granum-space/cansat-2016/documents/макет.jpg

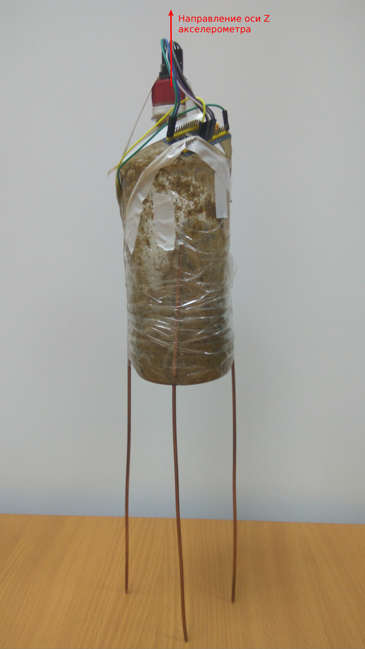
documents/макет.jpg
