granum-space/cansat-2016/documents/фото с полигона.jpg

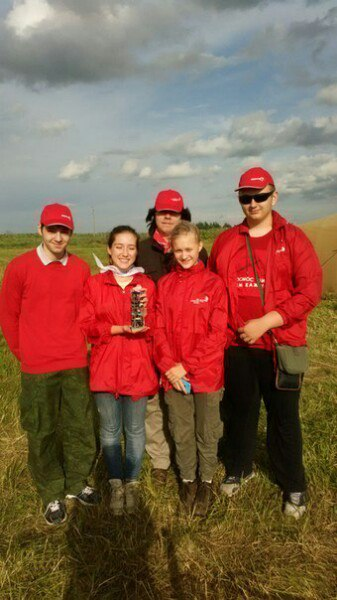
documents/фото с полигона.jpg
