granum-space/cansat-2016/README.md

# cansat-2016
проект команды granum конкурса cansat 2016
