granum-space/cansat-2016/schematics/README.md

# cansat-2016
Электронные схемы аппарата
