granum-space/cansat-2016/src-ground/README.md

# cansat-2016
Проект обработки телеметрии
