granum-space/cansat-2016/structure/README.md

# cansat-2016
Конструкция корпуса (модели/чертежи)
