granum-space/cansat-2016/documents/Granum Summer session 2017.pptx

## Granum

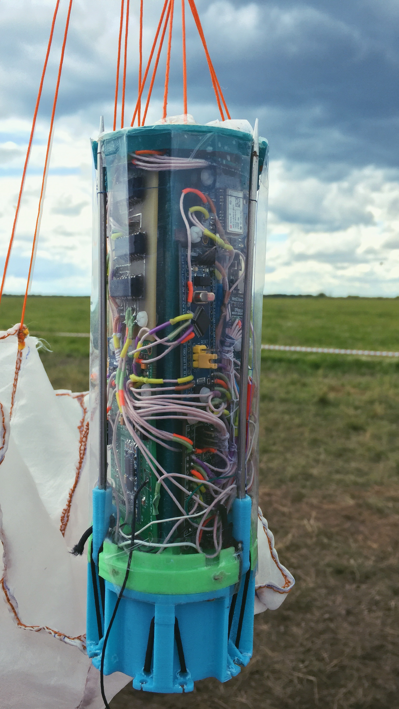
[picture p3: figure]

Проект 2501-2 «Е.Н.О.Т»

- В рамках воздушно-инженерной школы «CanSat в России»

Над проектом работали:
Елютин Кирилл,
Журавлёва Инга,
Хрисанова Анна,
руководитель:
Прокопьев василий

## ЗАДАЧИ аппарата

Задачи основной программы | Задачи дополнительной программы
Обеспечение плавного спуска и посадки | Измерение параметров почвы (электрическое сопротивление, твердость и температура)
Измерение давления, ускорения и температуры | Измерение относительной влажности воздуха
Передача собранных данных по радиоканалу | Измерение параметров освещенности
| Доставка семян
| Сохранение телеметрии на SD карту
| Определение координат аппарата по GPS

## Архитектура аппарата

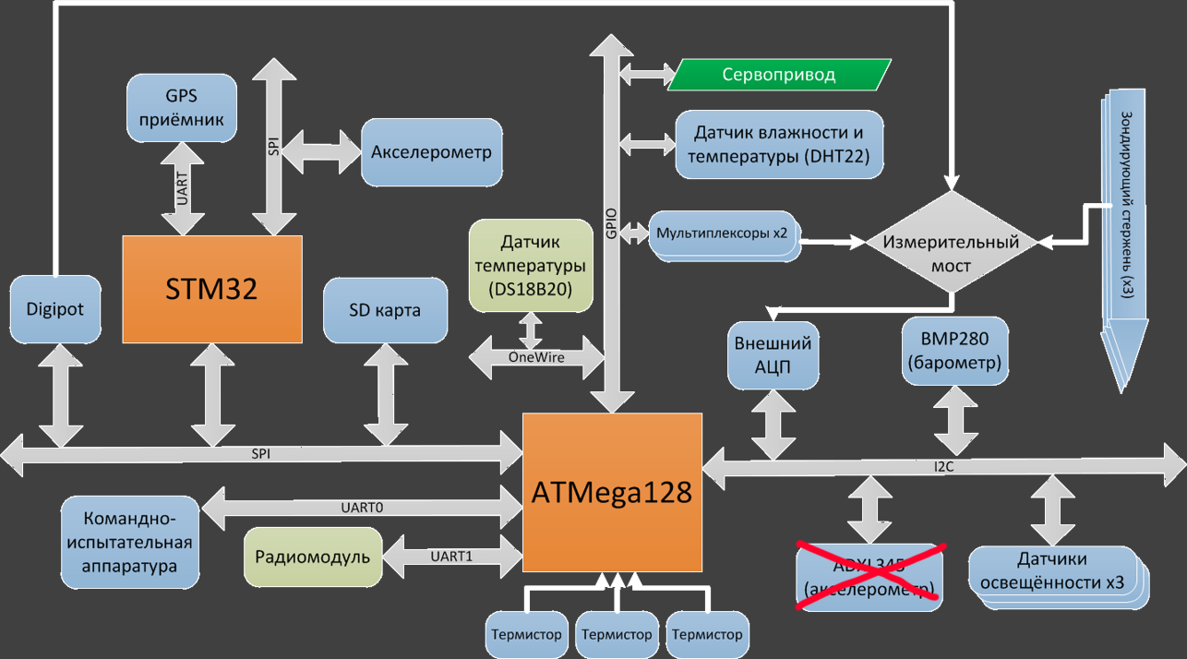
[picture p4: figure]

## Основная миссия

Измерение температуры

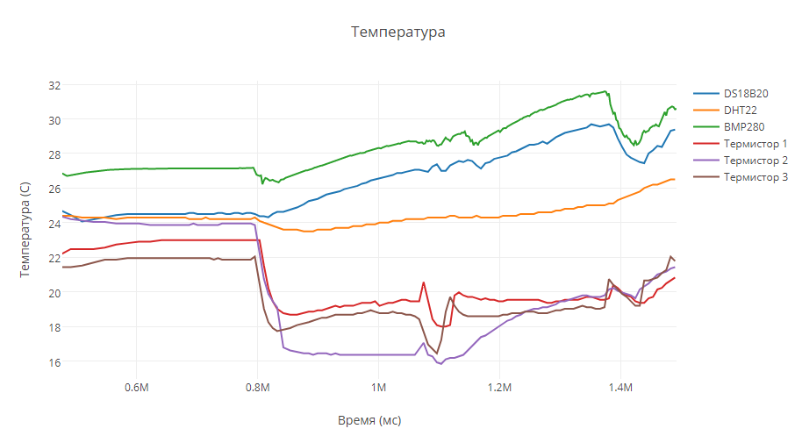
[picture p5: figure]
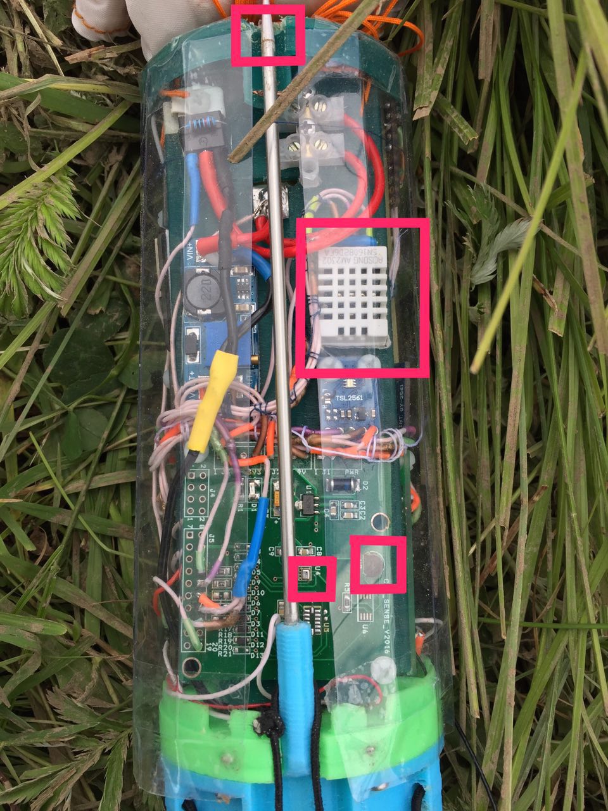
[picture p6: figure]

## Основная миссия

Измерение давления

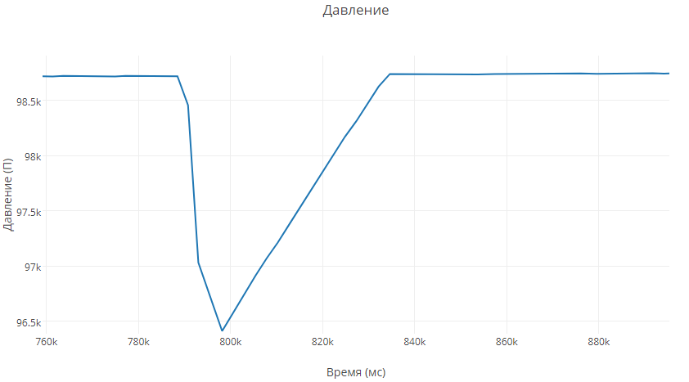
[picture p7: figure]
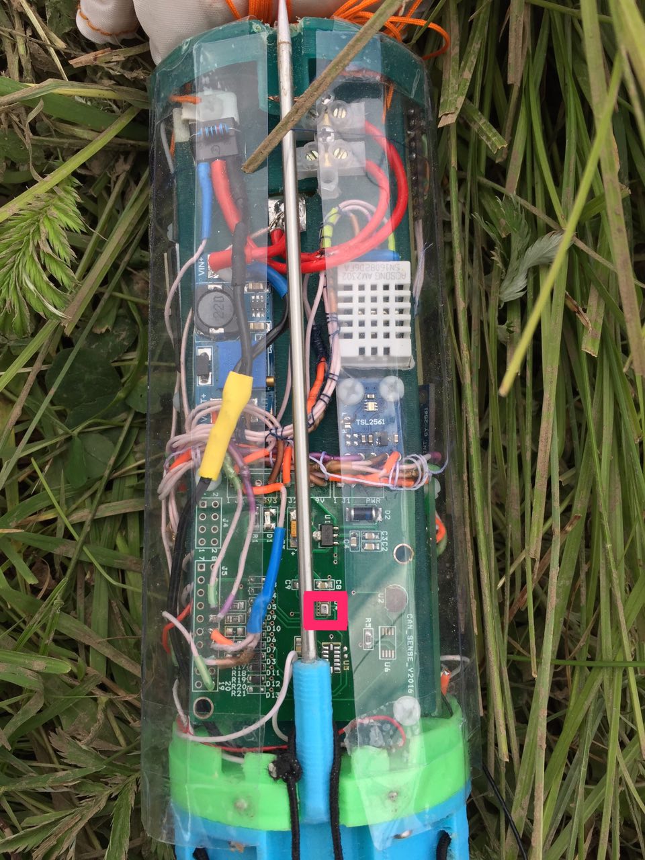
[picture p8: figure]
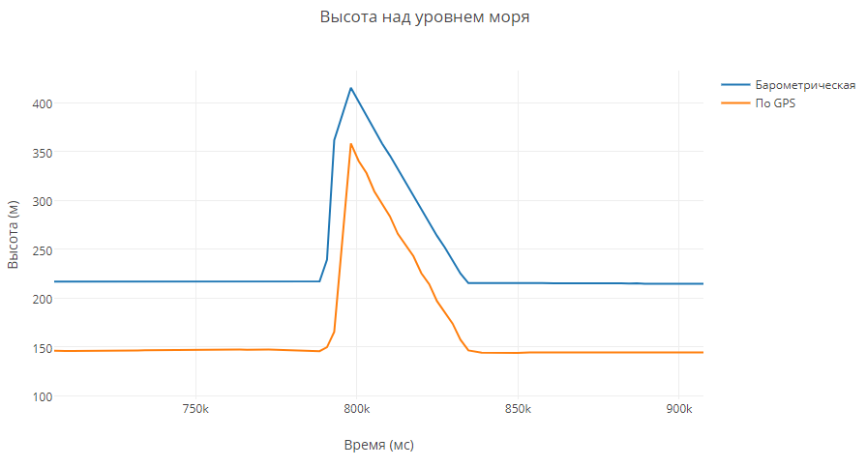
[picture p9: figure]

Скорость спуска ~ 5 м/с

Кинетическая энергия
полета: ~ 4.3 Дж

## дополнительная миссия

Измерение освещённости

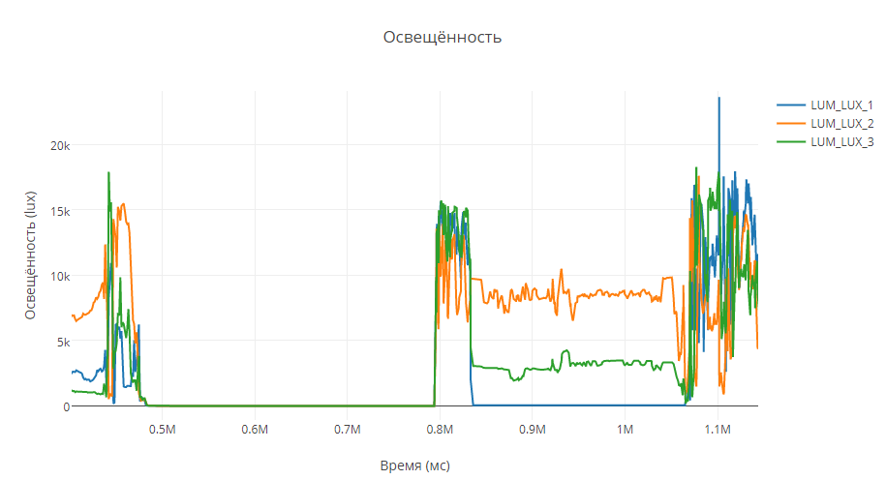
[picture p10: figure]
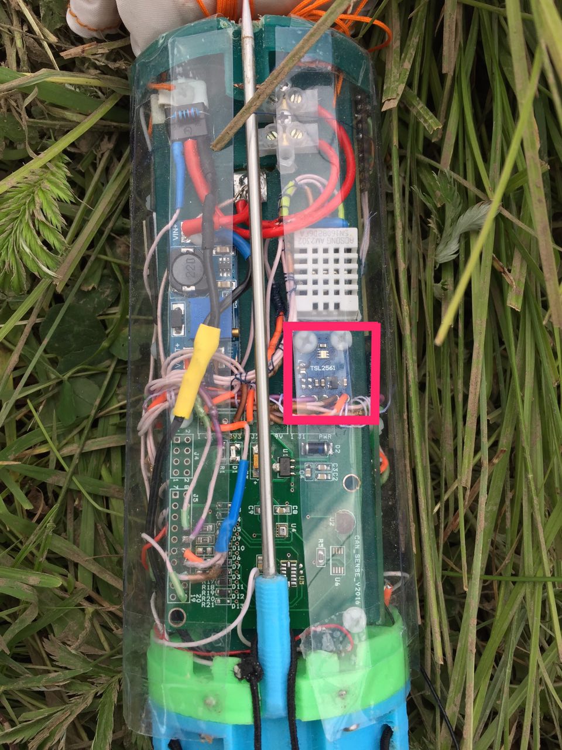
[picture p11: figure]
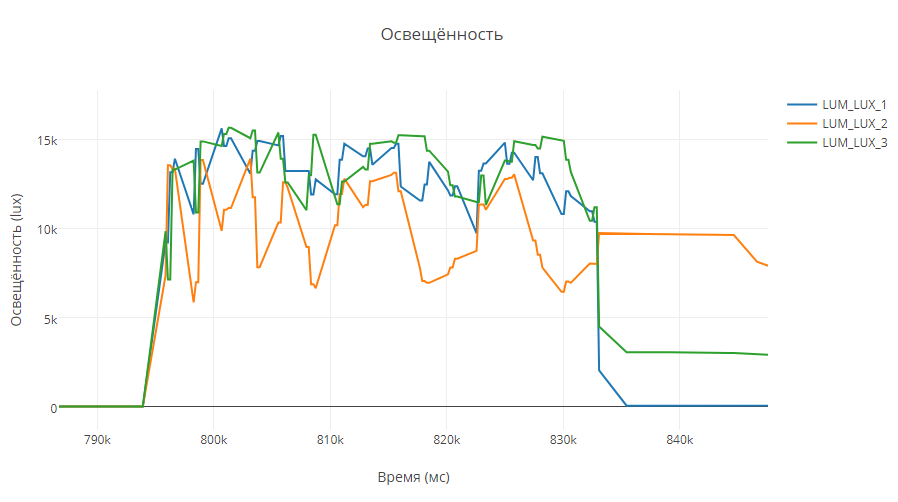
[picture p12: figure]

## дополнительная миссия

Измерение ускорений

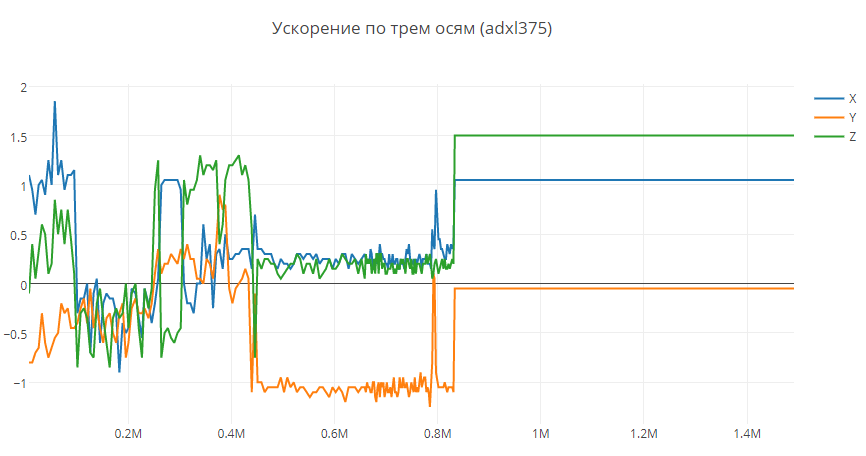
[picture p13: figure]
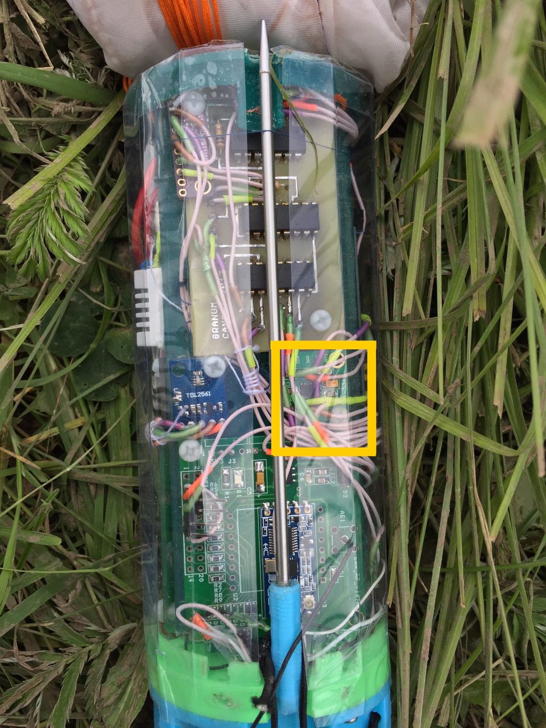
[picture p14: figure]
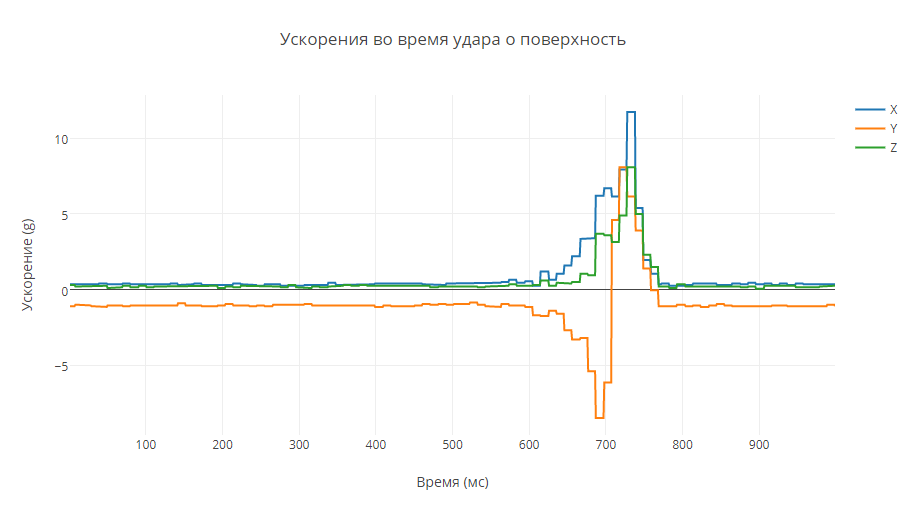
[picture p15: figure]

Время гашения удара: 100 мс

## дополнительная миссия

Измерение относительной влажности воздуха

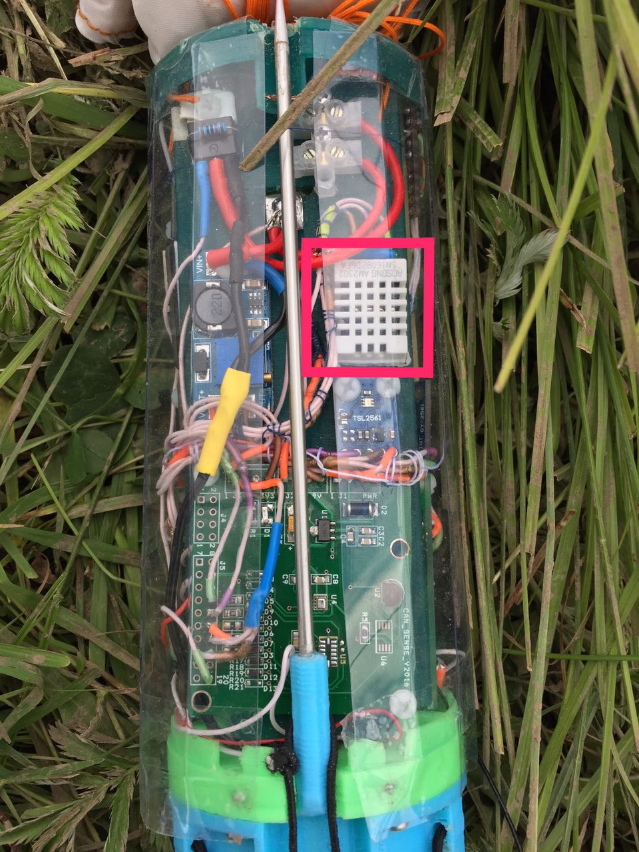
[picture p16: figure]
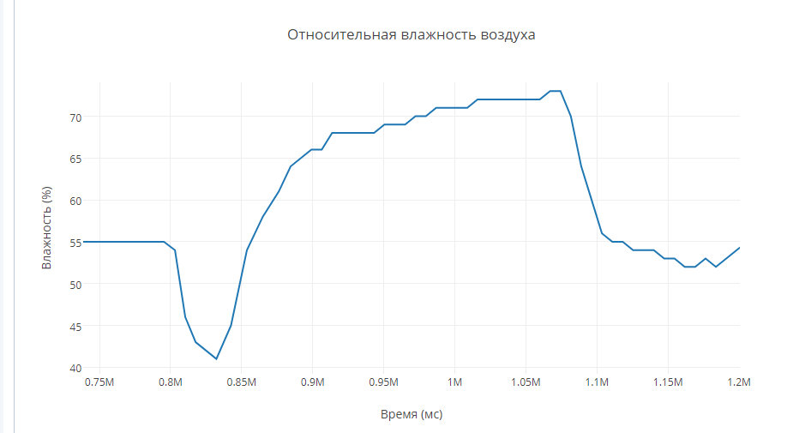
[picture p17: figure]

## дополнительная миссия

Измерение сопротивления почвы

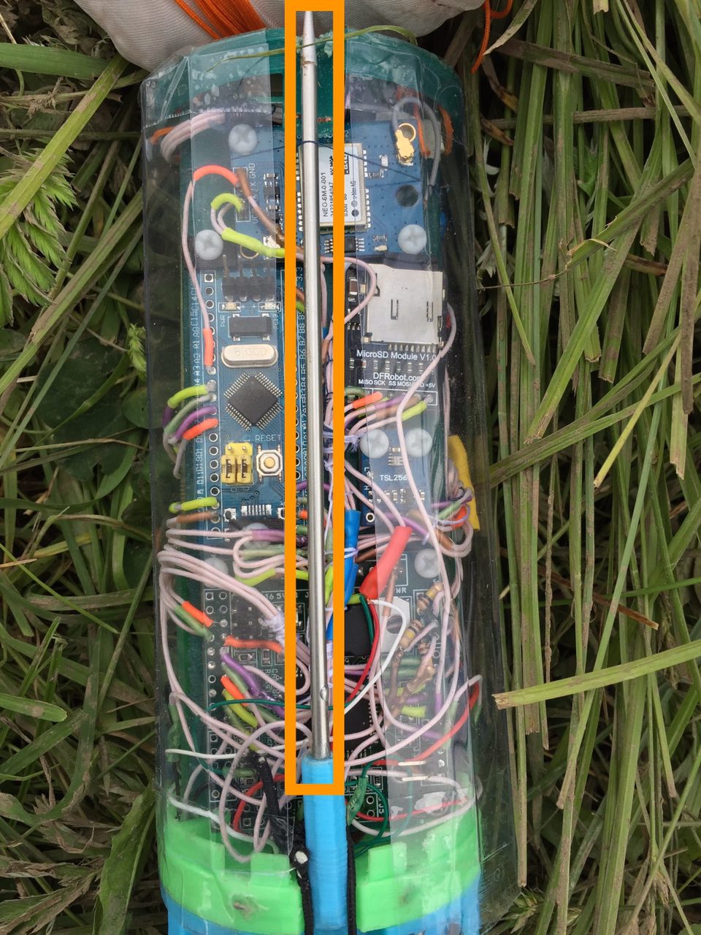
[picture p18: figure]
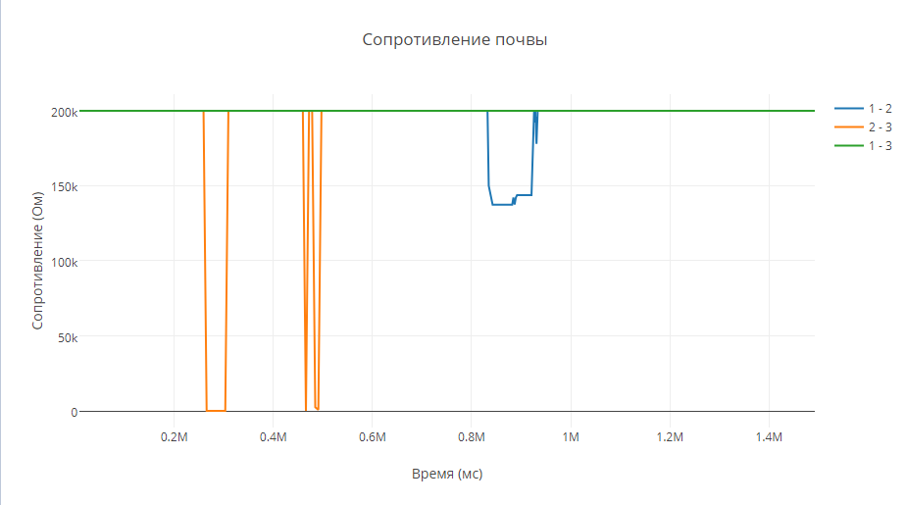
[picture p19: figure]

## дополнительная миссия

Разброс семян

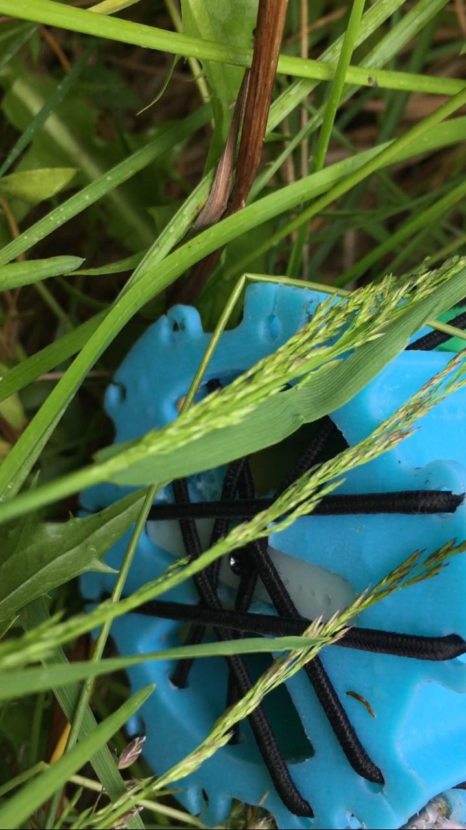
[picture p20: figure]
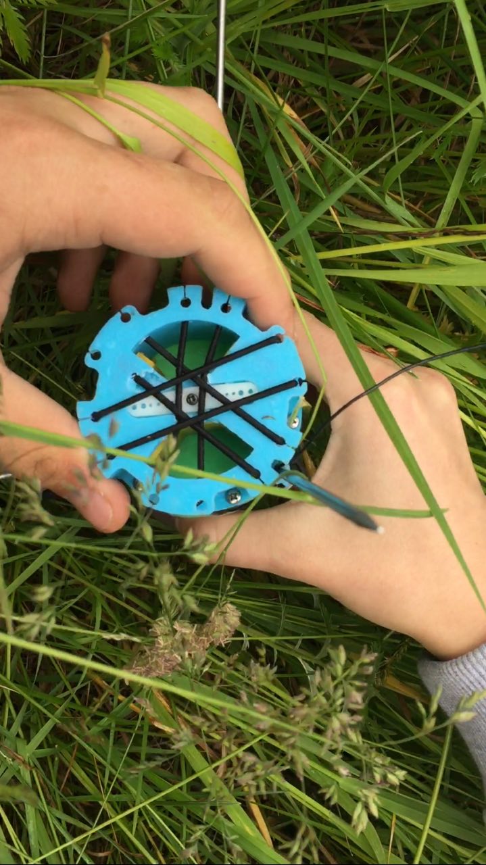
[picture p21: figure]

## результаты

- Сложенный парашют занимает больше двух сантиметров в высоту
- Все заявленные миссии выполнены в полном объеме без аппаратных и программных отказов в процессе полета
- Изучаемая планета по анализируемым параметрам пригодна для выращивания растений и похоже, что там что-то уже растет
