granum-space/cansat-2016/documents/Cansat-release.pdf

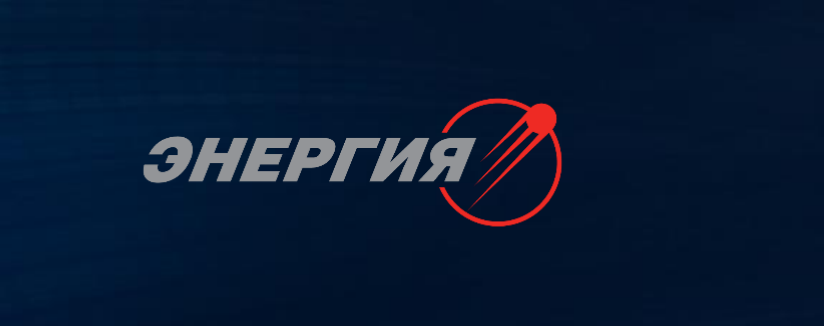
[picture p27: figure]

# Проект CanSat команды «Granum»

ЕКИМИАНИ Д., ЕЛЮТИН К., ЖУРАВЛЁВА И., НЕМИРОВА К., ХРИСАНОВА А.
КУРАТОР: ПРОКОПЬ ЕВ В.

# Цель проекта

### - Целью нашего проекта является создание аппарата для отработки некоторых компонентов, необходимых для изучения возможности

выращивания растений на удалённых планетах.

Задачи основной программы | Задачи дополнительной программы
Обеспечение плавного спуска и посадки | Измерение параметров атмосферы (влажность и содержаниеCО2 и О2)
Измерение давления и температуры | Измерение параметров почвы (электрическое сопротивление, твердость и температура)
| Измерение параметров освещенности на поверхности
| Доставка семян и бактерий

# Конструкция аппарата

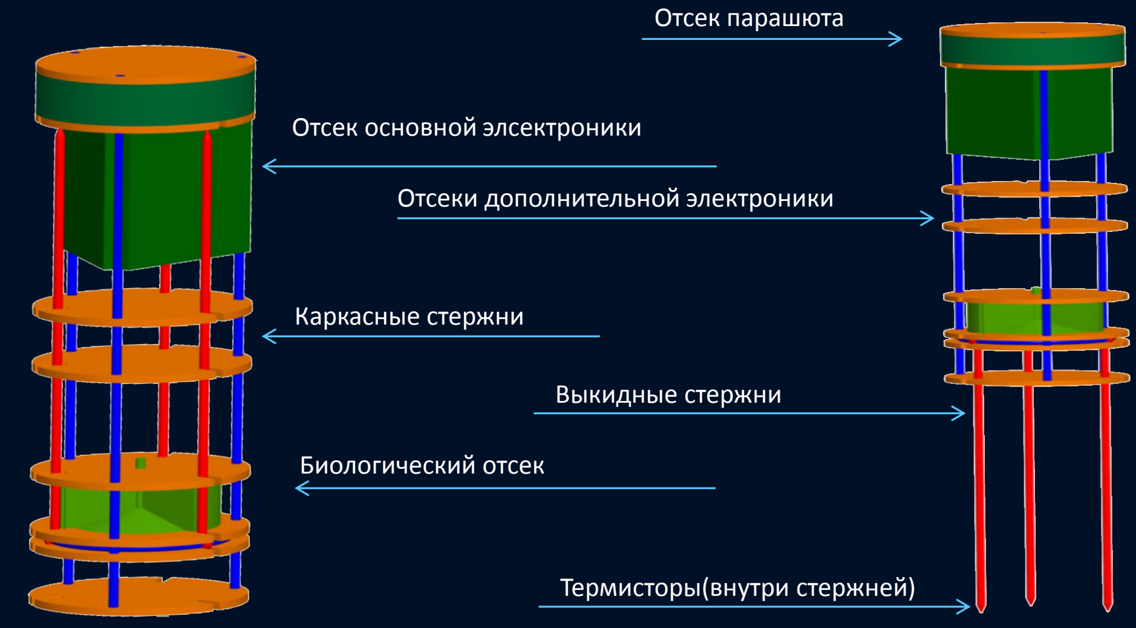
[picture p28: figure]
Отсек парашюта; Отсек основной элсектроники; Биологический отсек; Каркасные стержни; Выкидные стержни; Отсеки дополнительной электроники; Термисторы(внутри стержней)

# Конструкция аппарата

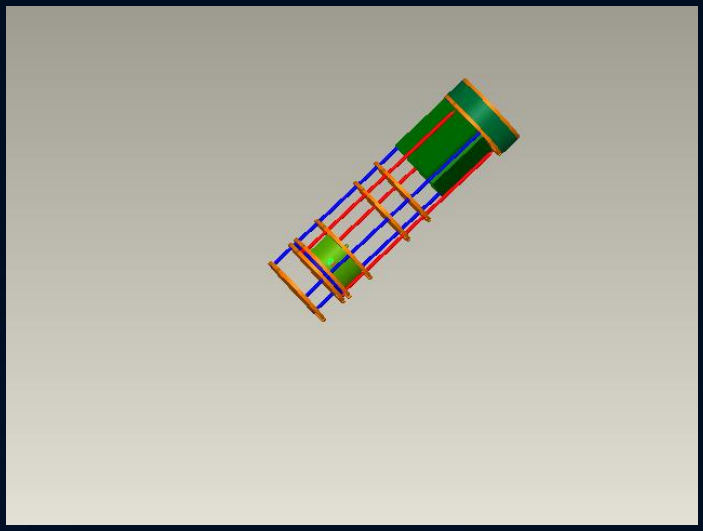
[picture p29: figure]

Механизм выбрасывания стержня-зонда

# Этапы полёта

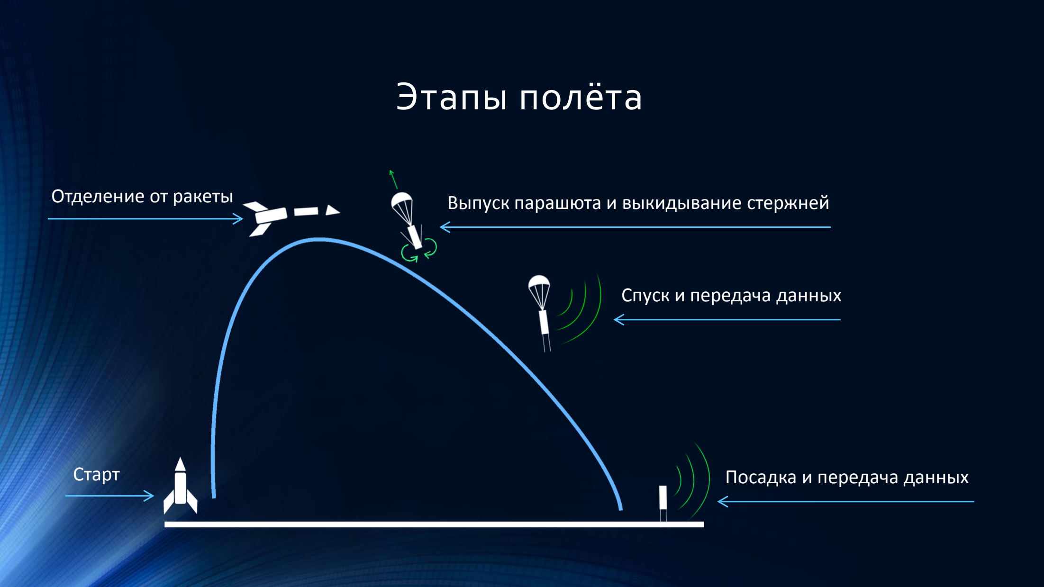
[picture p30: page 5]

Старт

Отделение от ракеты | Выпуск парашюта и выкидывание стержней

Спуск и передача данных

Посадка и передача данных

# Моделирование движения стержней-зондов в почве

### - Сопротивление почвы смятию стержнями аналогично силе упругости и рассчитывается по формуле: F x = −q ∗ 2 ∗ π ∗ r

2

### ∗ 3 ∗ 1.3 ∗ x = −k ∗ x

### Через закон сохранения энергии возможно выразить глубину погружения стержней аппарата от скорости спуска и твердости почвы:

x =

v m

### q ∗ 2 ∗ π ∗ r

2 ∗ 3 ∗ 1.3

# Моделирование движения стержней-зондов в почве

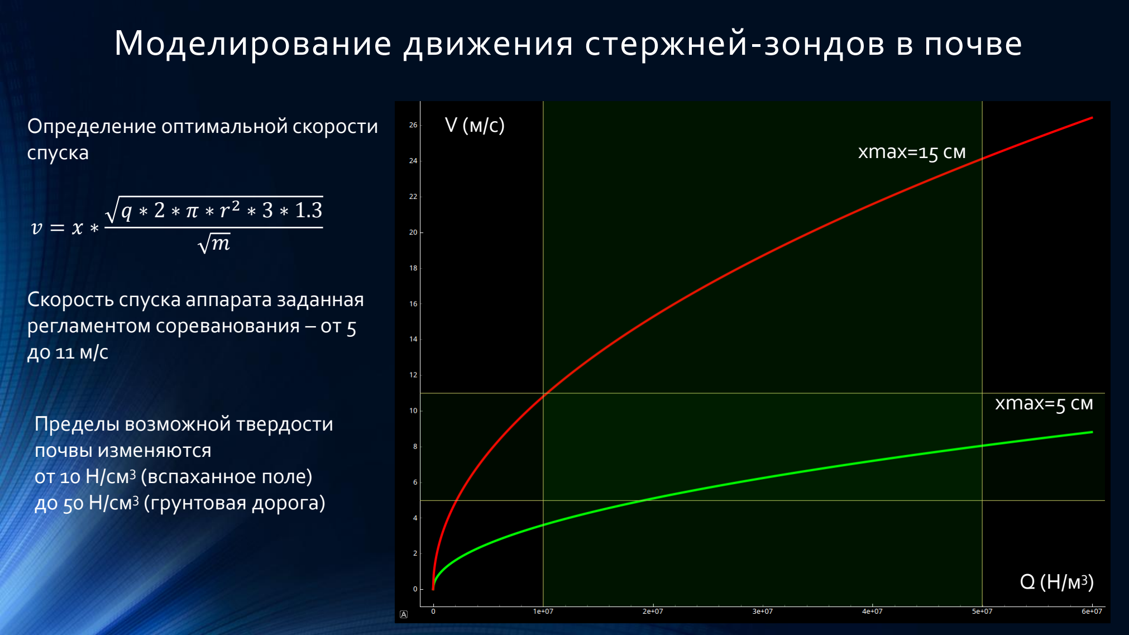
[picture p31: page 7]

V (м/c)

Q (Н/м³
)

v = x ∗

q ∗ 2 ∗ π ∗ r

2 ∗ 3 ∗ 1.3
m

Определение оптимальной скорости
спуска | xmax=15 см

xmax=5 см
Пределы возможной твердости почвы изменяются
от 10 Н/см³
(вспаханное поле)
до 50 Н/см³
(грунтовая дорога)

Скорость спуска аппарата заданная регламентом сореванования – от 5 до 11 м/c

# Моделирование движения стержней-зондов в почве

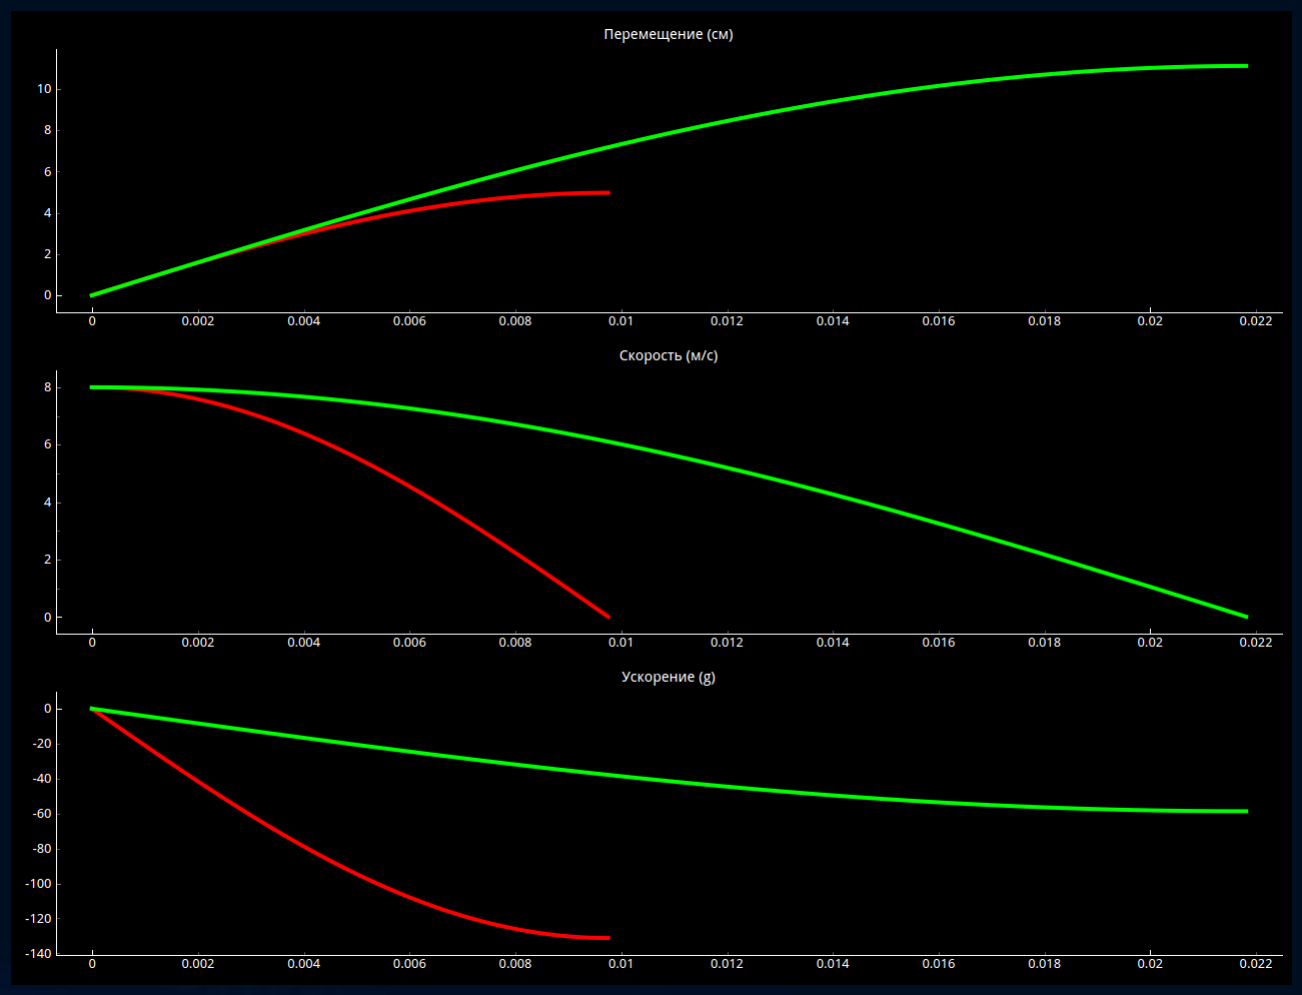
[picture p32: figure]

### Движение тела под действием пружины описывается формулой:

### - X(t)= v0

m
k

### ∗ sin(

m
k

t)

### - v(t)= v0

m
k

### ∗ cos(

m
k

t)

### - a(t)= -v0

m²
k²

### ∗ cos

m
k

t

### - Из графика функций видно, что ускорение

не превышает 140g и длится не более 10 мс,

### что является приемлемыми значениями

для конструкции.

# Расчет парашюта

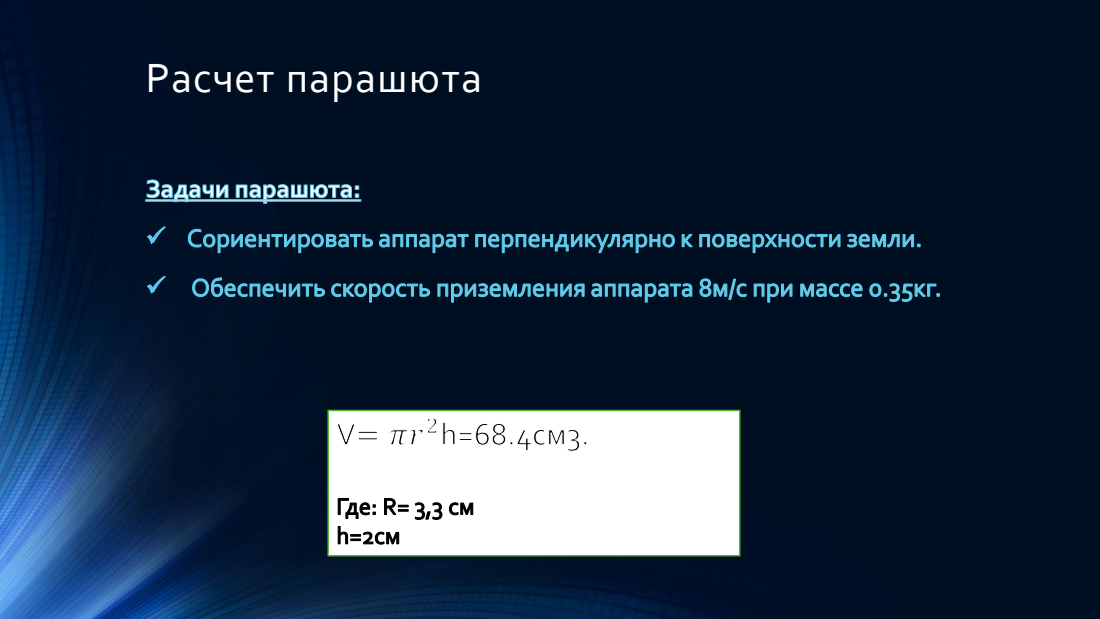
[picture p33: page 9]

# Аэродинамический расчет парашюта

Расчет площади парашюта | Расчет диаметра купола парашюта

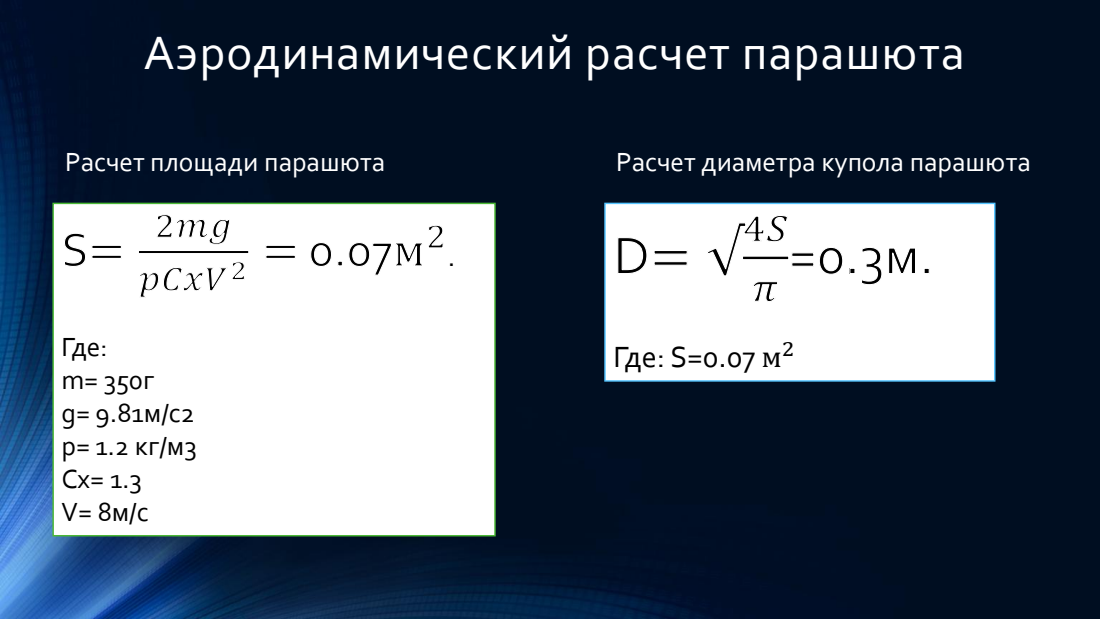
[picture p34: page 10]
Где: m= 350г g= 9.81м/с2 p= 1.2 кг/м3 Cx= 1.3 V= 8м/с; Где: S=0.07 м

H1

D1

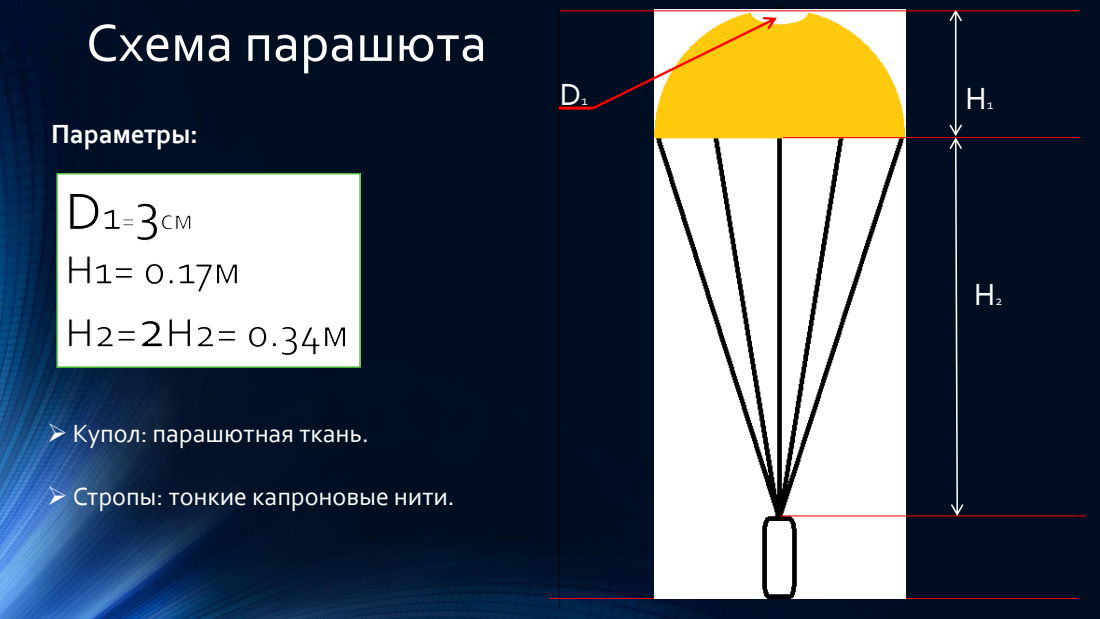
[picture p35: page 11]
Схема парашюта; Параметры:

Купол: парашютная ткань.

Стропы: тонкие капроновые нити.

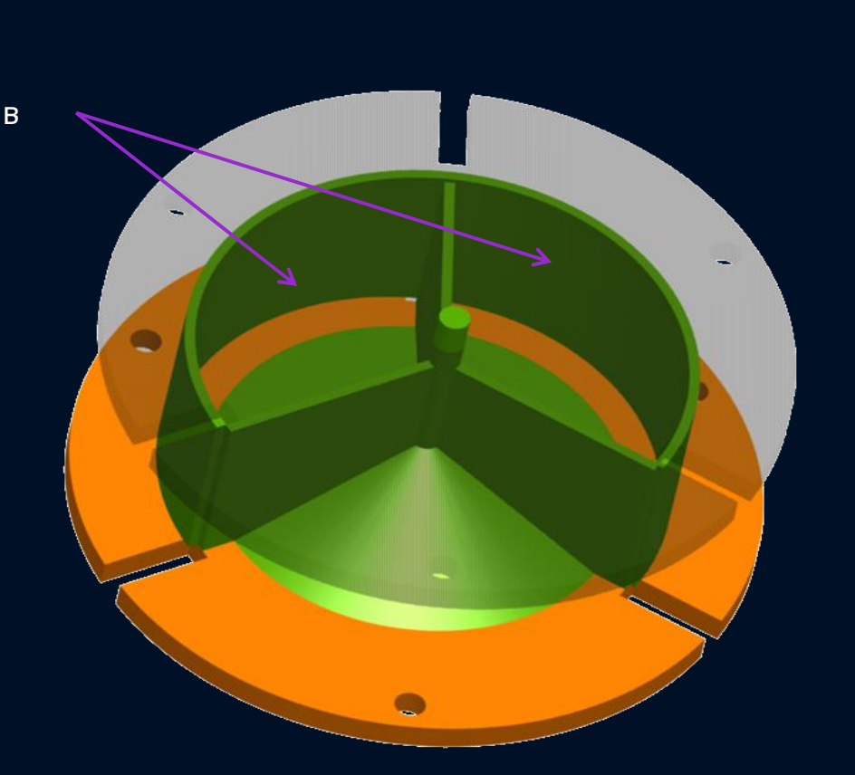
[picture p36: figure]

Здесь находятся семена и бактерии в гранулах

# Конструкция биологического отсека

# Система измерения электрического сопротивления почвы

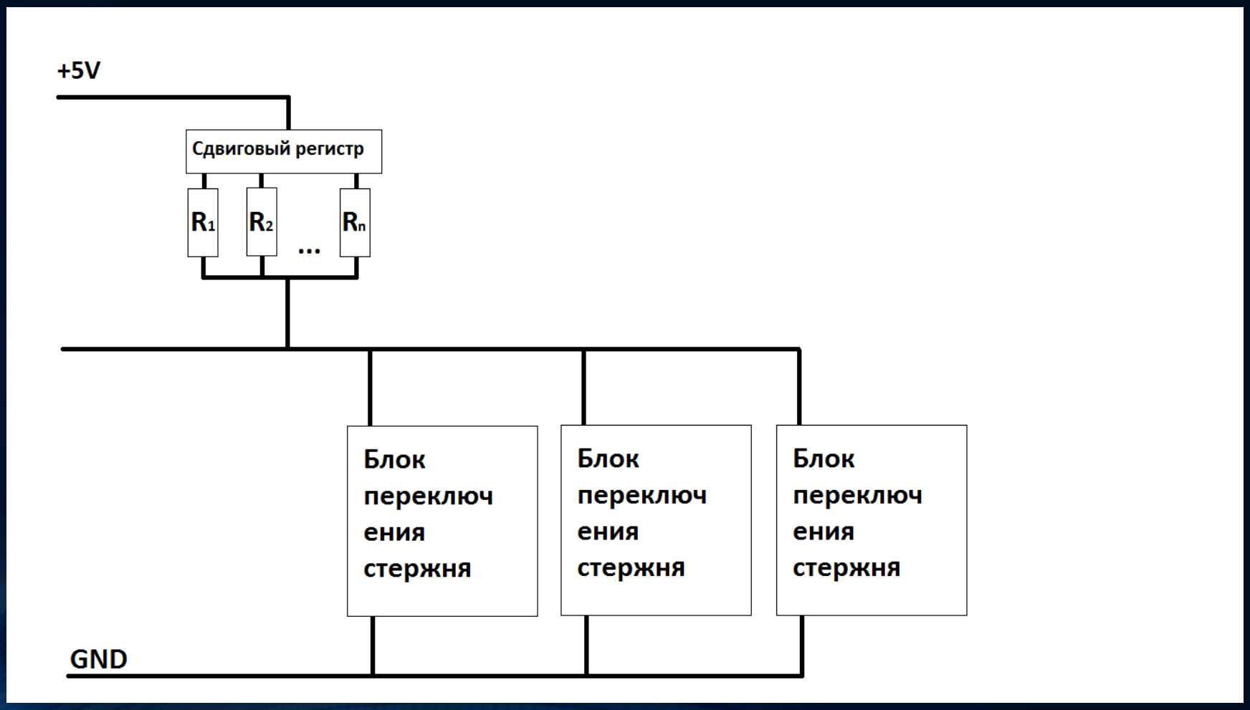
[picture p37: figure]

К измерительной
цепи

# Блок переключения стержня

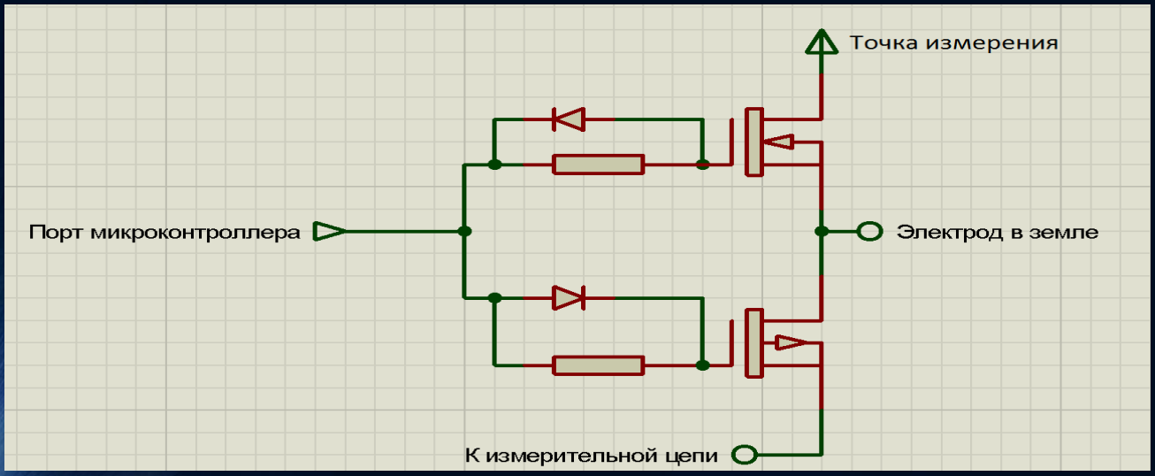
[picture p38: figure]

# Датчики

Датчик | Название Пределы | ТочностьИнтерфейс
Акселерометр | ADXL375 | ±200g, три оси | ±50mg | SPI/IIC до 1600 Hz
Влажности и температуры | DHT22 | 0-100% -40-80°с | ±2% ±0,5°c | 1-wire
Кислорода | SK 25F | 0-30%O2 | ±1% | Аналоговый
Углекислого газа | CDM4161 a | 400-4000 ppm | ±20% | Аналоговый
Компонент | Ток
Atmega128 | 50mA
DHT22 | 1.5mA
CDM4161A | 100mA
MPX5100 | 10mA
ADXL375 | 1mA
DS18B20 | 5mA
RXQ3-443 | 30mA
| 197,5mA

# Накопление собранных данных

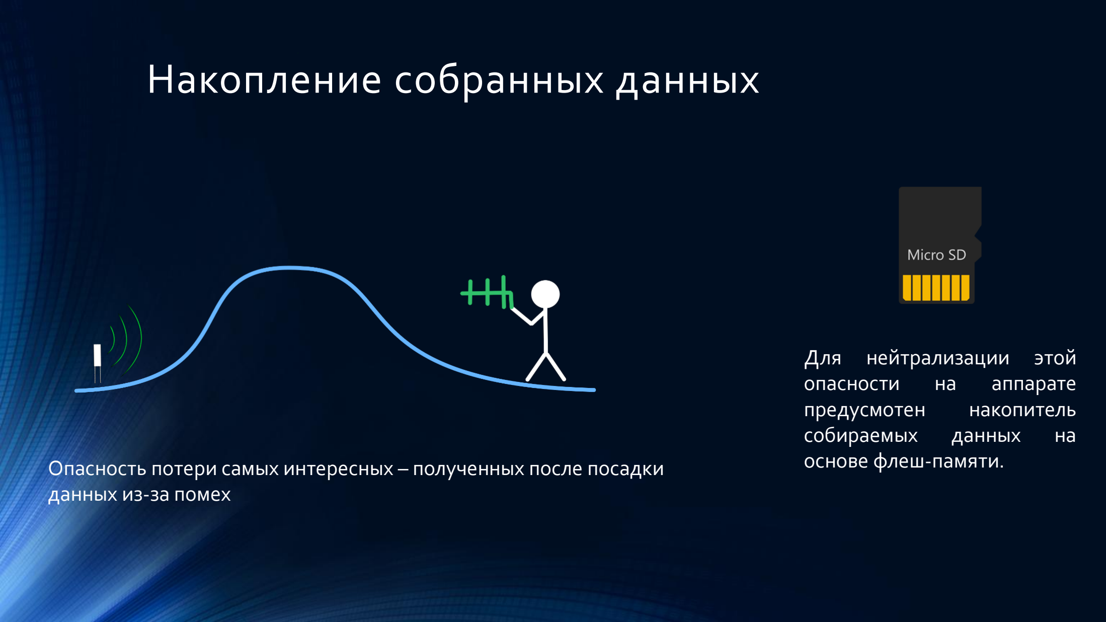
[picture p39: page 16]

Опасность потери самых интересных – полученных после посадки данных из-за помех

Для нейтрализации этой
опасности | на | аппарате
предусмотен | накопитель
собираемых | данных | на
основе флеш-памяти.

# Наземная обработка полученных данных

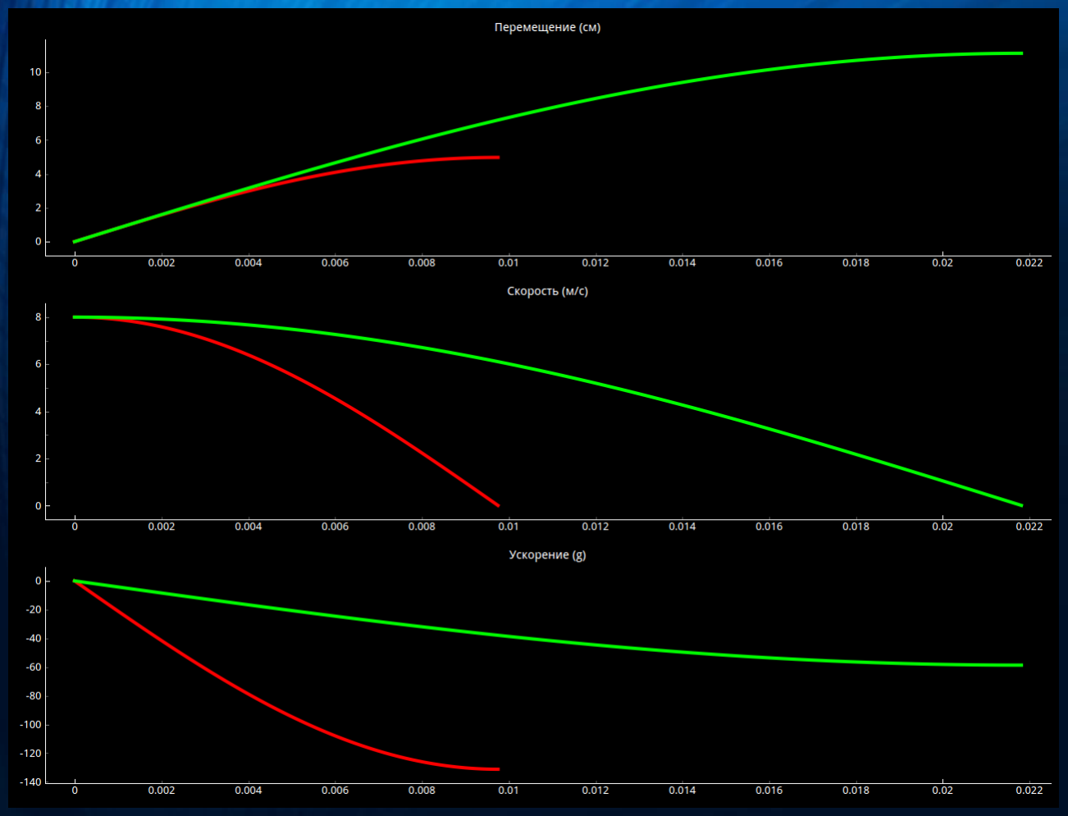
[picture p40: figure]

Используя показания акселерометра и метод двойного интегрирования мы можем определить глубину погружения стержней-зондов в почву. На основании этих данных мы можем судить о ее твердости

На основании полученных данных о твердости, электропроводности и температуре мы можем получить представление о составе почвы и ее свойствах (теплопроводности), следовательно о пригодности к прорастанию семян.

На основании данных атмосферы, полученных во время спуска, можем судить о наличии газов, необходимых для жизни растений.

### - Для определения удельного сопротивления почвы мы используем формулу Дуайта:

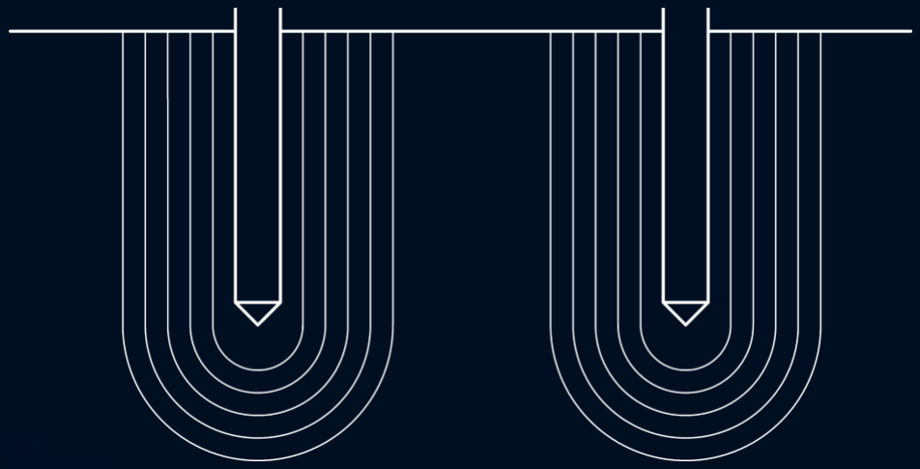
[picture p41: figure]

R =

ρ
2πl

∗

ln 4L −1
r

,

ρ =

### R ∗ r ∗ 2πl ln 4L − 1

# Наземная обработка полученных данных

# Масса аппарата

Наименование | Масса, г | Количество | Итого, г
Акселерометр (ADXL375) | 0.30 | 1.00 | 1.00
microSD с держателем | 3.00 | 1.00 | 3.00
Платы стандартного конструктора | 43.00 | 1.00 | 43.00
Термистор | 1.00 | 3.00 | 3.00
Датчик кислорода (25F) | 7.00 | 1.00 | 7.00
Модуль измерения количества CO2(CDM4161a) | 6.00 | 1.00 | 6.00
Датчик влажности и температуры(DHT22) | 9.00 | 1.00 | 9.00
Парашютная система | 15.00 | 1.00 | 15.00
Батарея | 15.00 | 3.00 | 45.00
Семена (1 см^3) | 0.39 | 68.40 | 25.00
Механизм рассыпания семян | 8.06 | 1.00 | 8.06
Зонд (h=200mm,r_o=3, r_i=2mm) | 6.14 | 3.00 | 18.42
Итог: | | | 183.48
Остается на корпус | 166.52

# Аварийные ситуации

Аварийные ситуации | Последствия | Меры предосторожности
1.Не раскроется парашют | Аппарат разобьется. | Правильная укладка парашюта в отсек
2.Отказ отдельных элементов электроники: а) Микропроцессор | Полная потеря управления над аппаратом и связи с ним. | Нет
б) Датчики | Потеря данных, собираемых во время полета и приземления. | Нет
в) Исполнительные устройства | Частичная потеря управления над аппаратом. | Резервирование исполнительных органов
3.Падение: а) В водоем | Потеря данных, собираемых после посадки. | Нет
б) На камень | Возможна поломка выдвижных стержней. | Нет
в) В лес | Возможность застрять в ветках деревьев. | Пережигание нитей парашюта (появляется возможность падения)

# Заключение

Подводя итоги, хочется отметить, что наш проект полностью соответствует предоставленным требованиям, а то есть заданной массе и стоимости аппарата. И более того, по нашим расчетам, мы полностью сможем проделать заданные научные задачи. Исходя из всего вышеперечисленного, можно сказать, что большинство условий нами были учтены, и вероятность успешного исхода будущего запуска

достаточно высока.

# Спасибо за внимание!
