granum-space/cansat-2016/documents/42061520_w640_h2048_6110fs5.jpg

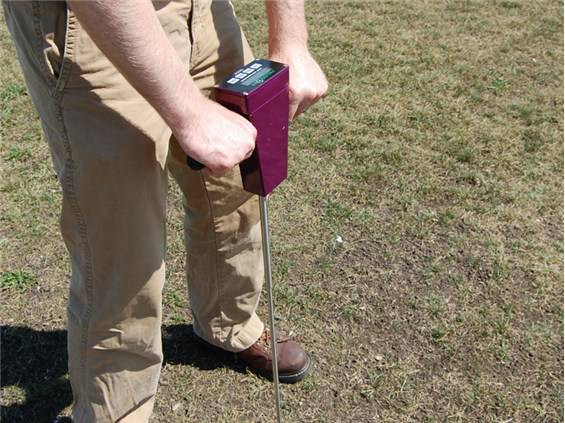
documents/42061520_w640_h2048_6110fs5.jpg
