granum-space/cansat-2016/documents/Cansat Flight Animation (1).gif

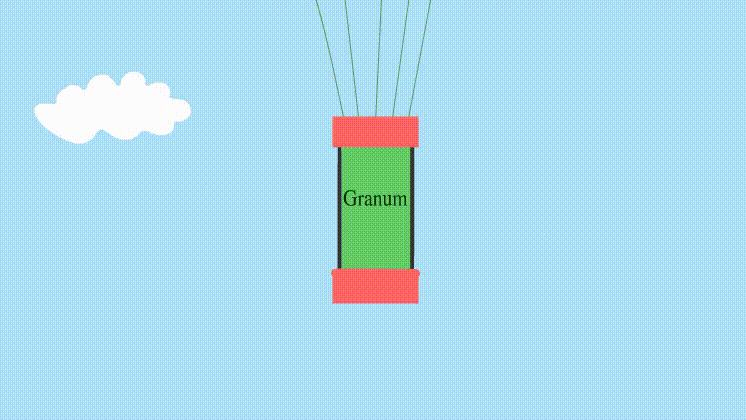
documents/Cansat Flight Animation (1).gif
