granum-space/cansat-2016/documents/image003_37.png

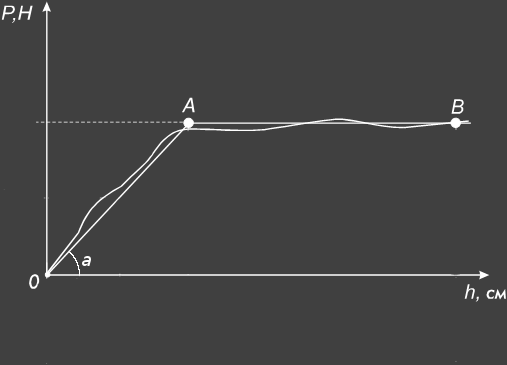
documents/image003_37.png
