granum-space/cansat-2016/documents/img/acc_plot.png

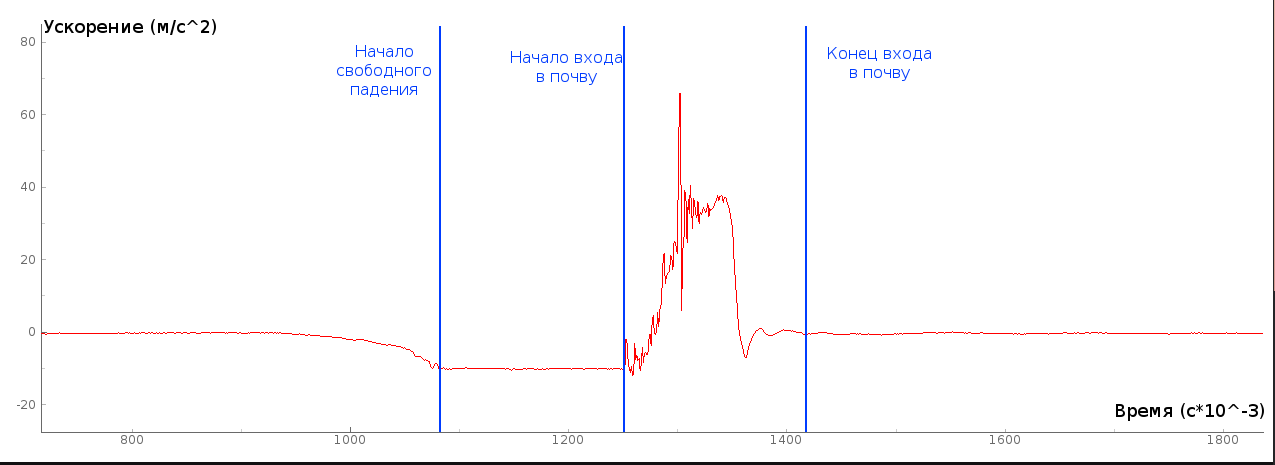
documents/img/acc_plot.png
