granum-space/cansat-2016/documents/img/acc_plot_triple.png

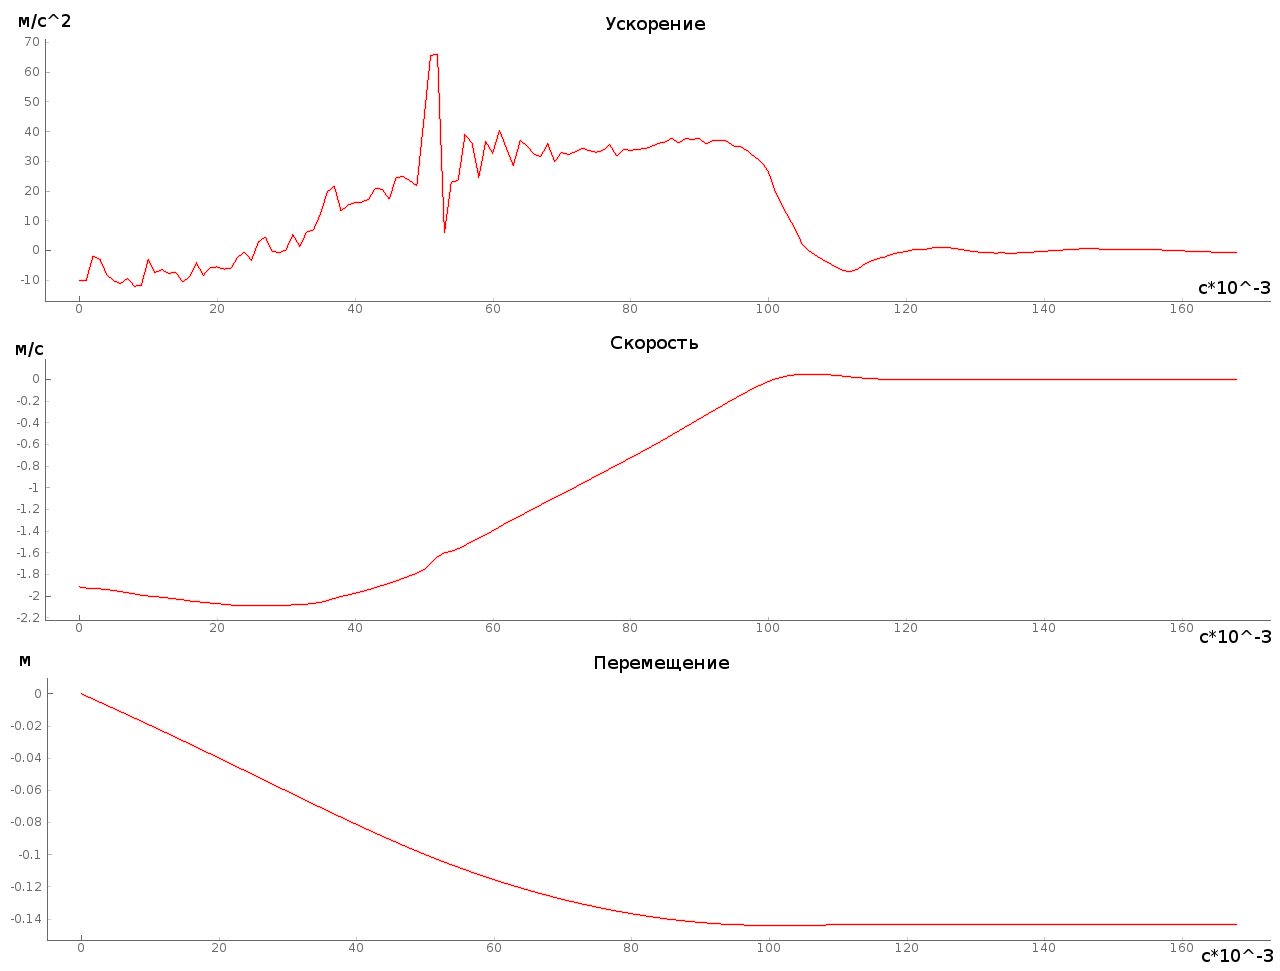
documents/img/acc_plot_triple.png
