granum-space/cansat-2016/documents/img/full.tif

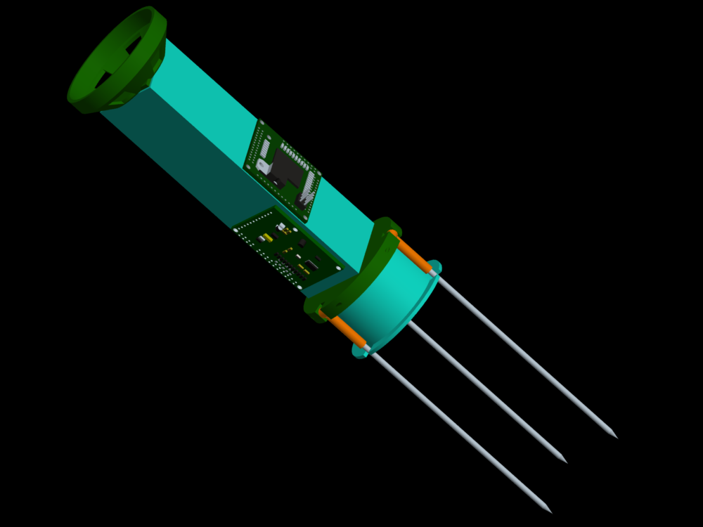
documents/img/full.tif
