granum-space/cansat-2016/documents/img/scheme.png

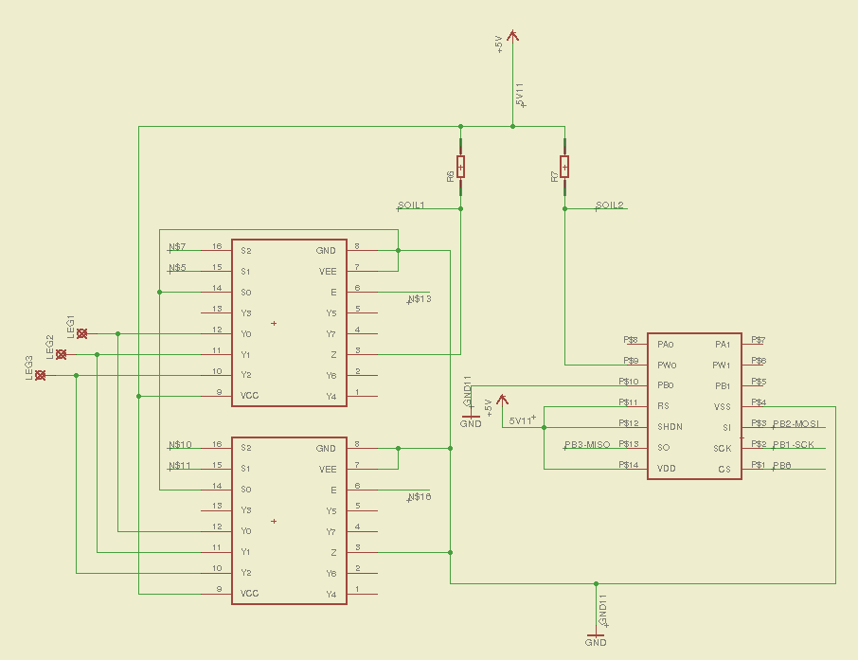
documents/img/scheme.png
