granum-space/cansat-2016/documents/img/seeds_1.tif

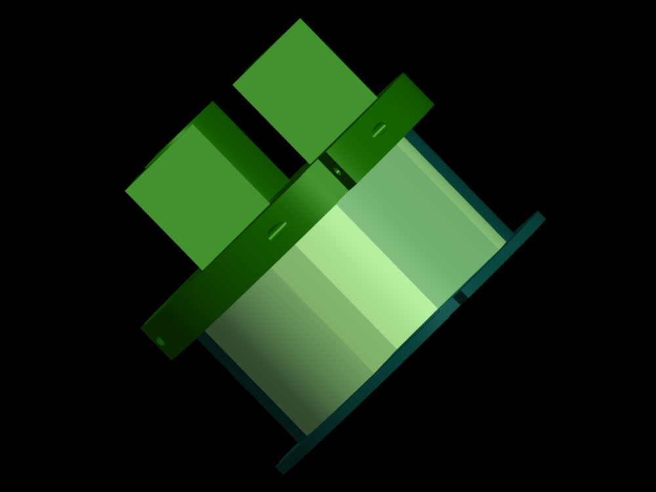
documents/img/seeds_1.tif
