granum-space/cansat-2016/documents/img/seeds_2.tif

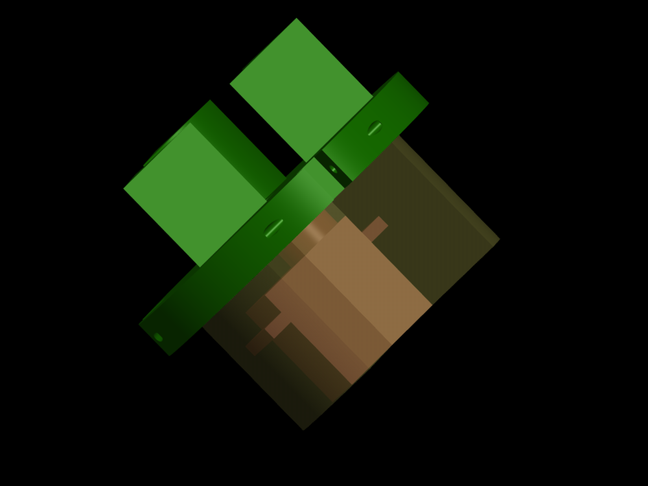
documents/img/seeds_2.tif
