granum-space/cansat-2016/documents/img/SEEDS_ASM.tif

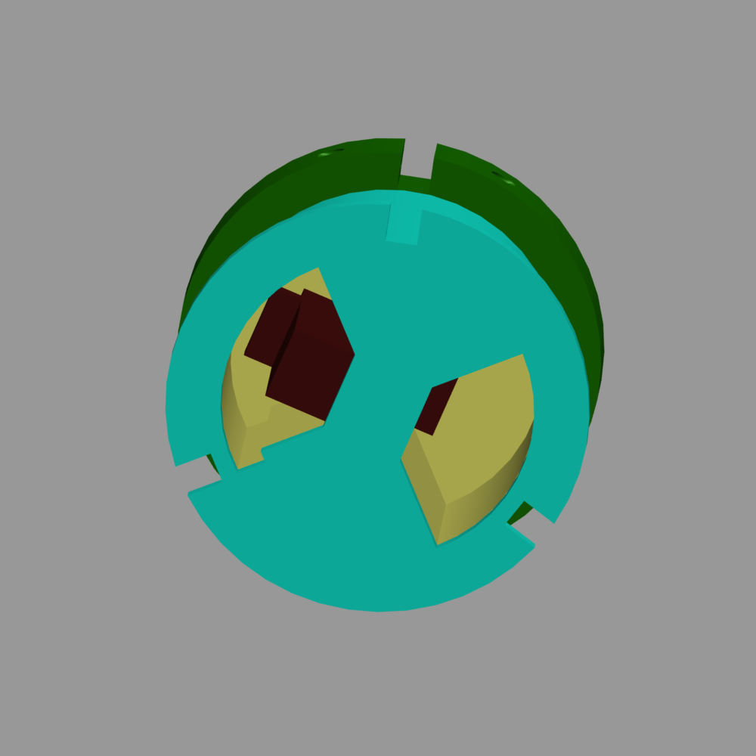
documents/img/SEEDS_ASM.tif
