granum-space/cansat-2016/documents/img/SEEDS_ASM_1.tif

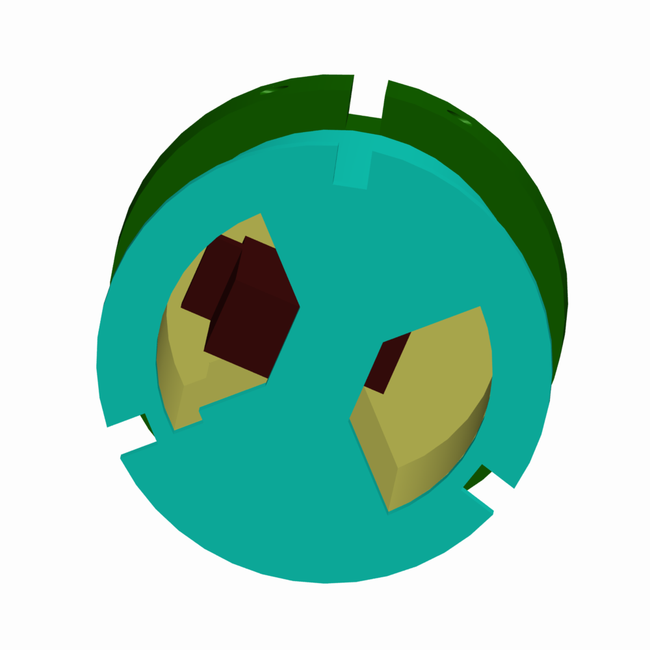
documents/img/SEEDS_ASM_1.tif
