granum-space/cansat-2016/documents/img/STAGE_PARACHUTE_ALT_2.tif

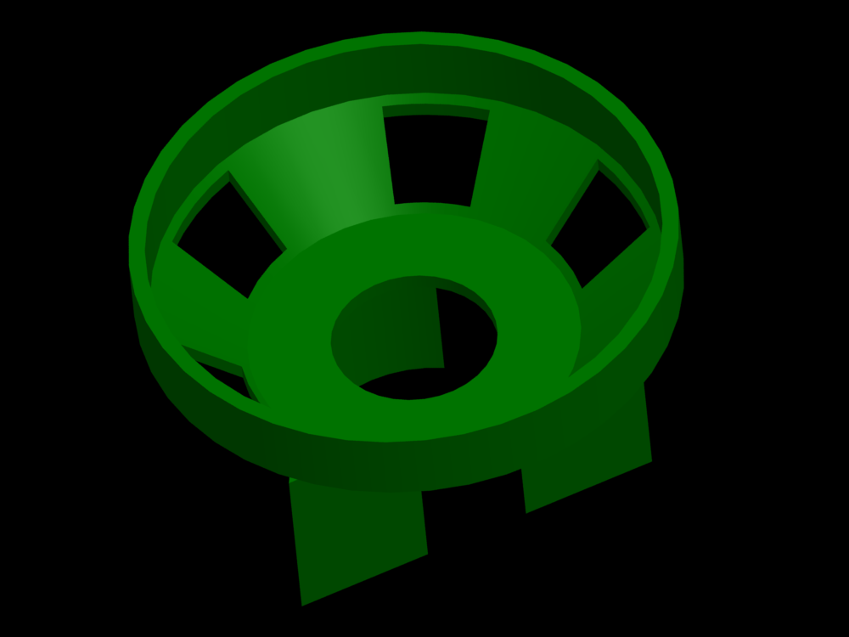
documents/img/STAGE_PARACHUTE_ALT_2.tif
