granum-space/cansat-2016/documents/img/stasge_parachute.tif

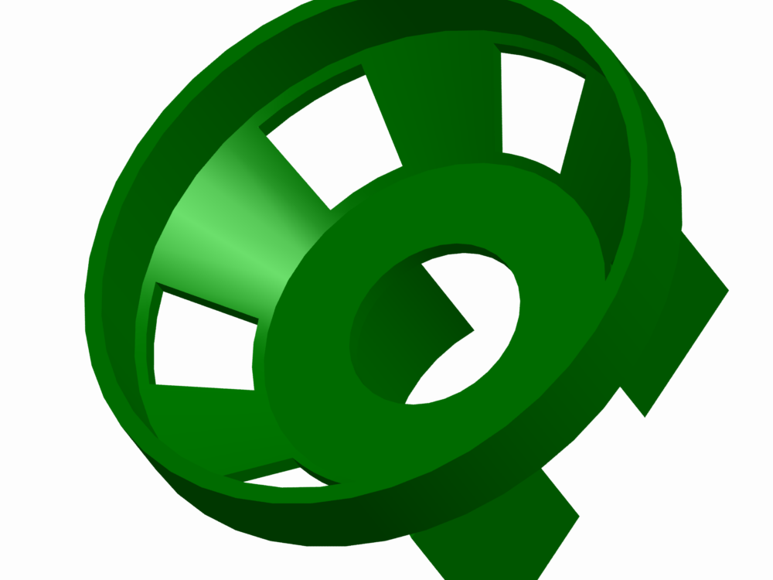
documents/img/stasge_parachute.tif
