granum-space/cansat-2016/documents/img/stasge_parachute_0.tif

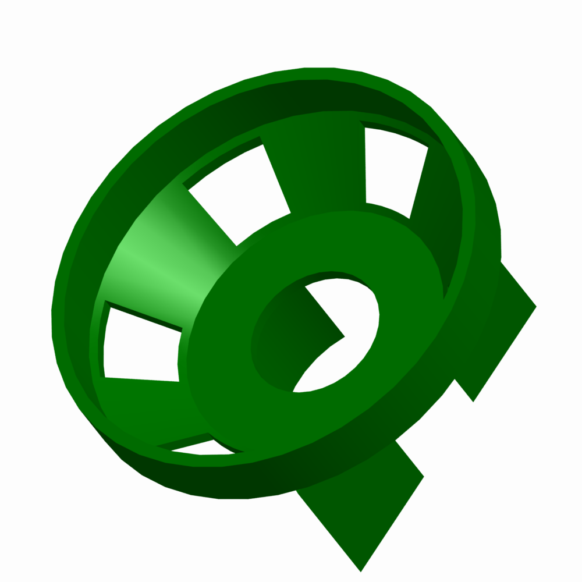
documents/img/stasge_parachute_0.tif
