granum-space/cansat-2016/documents/img/внутренности отсека семян.bmp

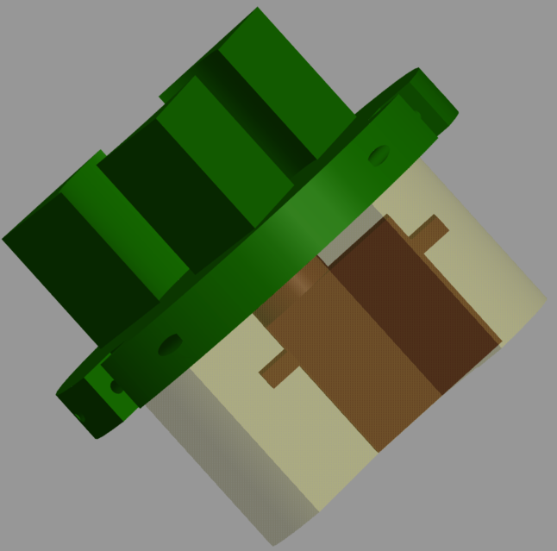
documents/img/внутренности отсека семян.bmp
