granum-space/cansat-2016/documents/img/модель аппарата.bmp

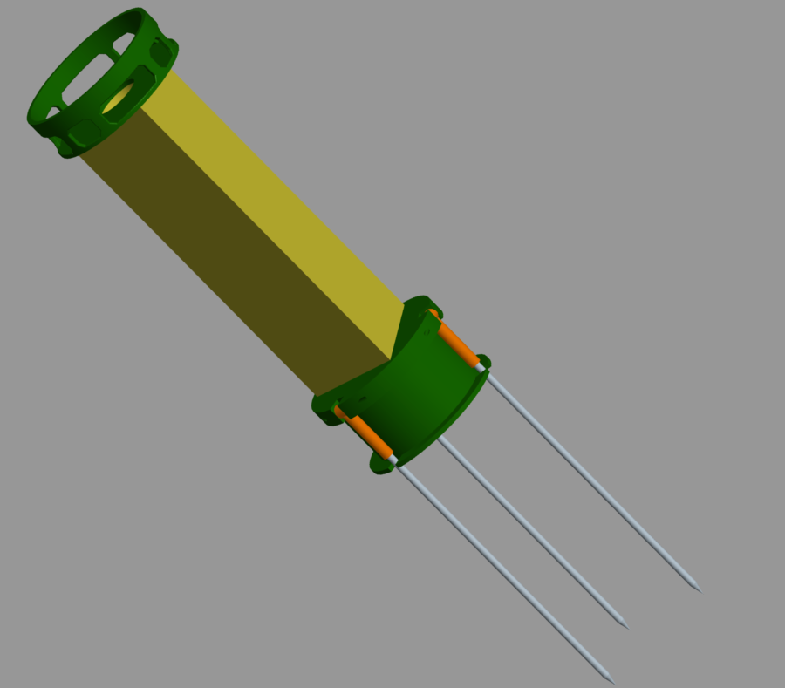
documents/img/модель аппарата.bmp
