granum-space/cansat-2016/documents/img/отсек для семян снизу.bmp

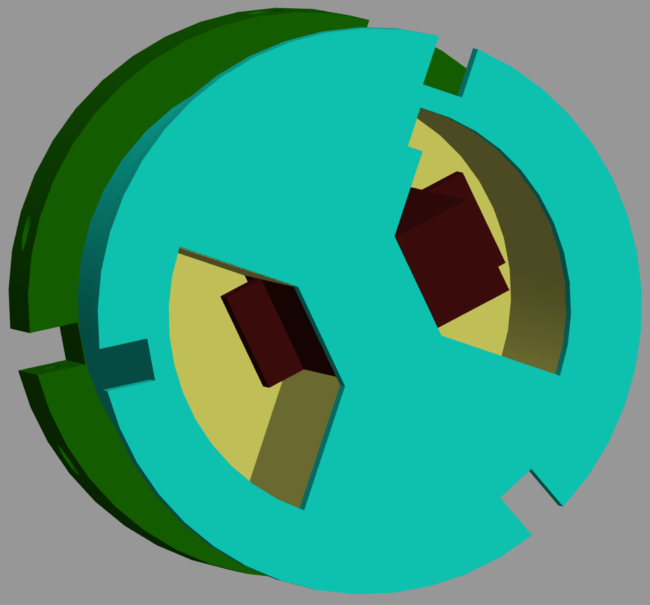
documents/img/отсек для семян снизу.bmp
