granum-space/cansat-2016/documents/img/отсек для семян.bmp

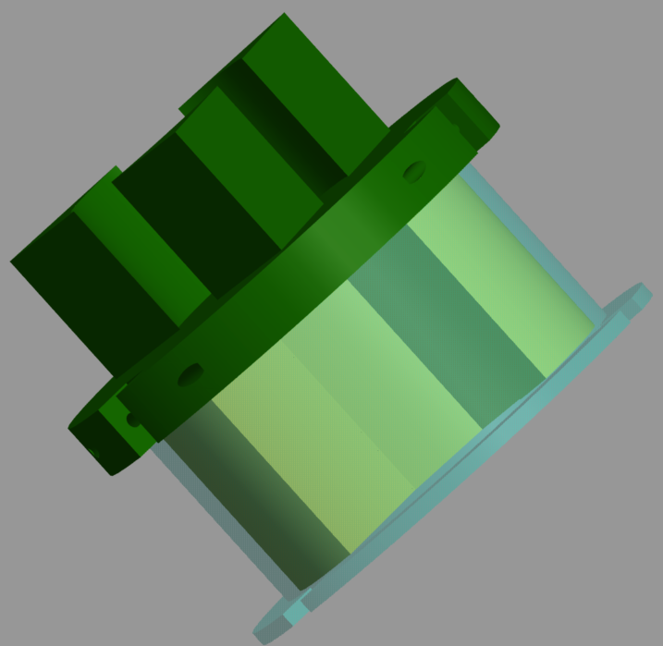
documents/img/отсек для семян.bmp
