granum-space/cansat-2016/documents/IMG_20170128_160929.jpg

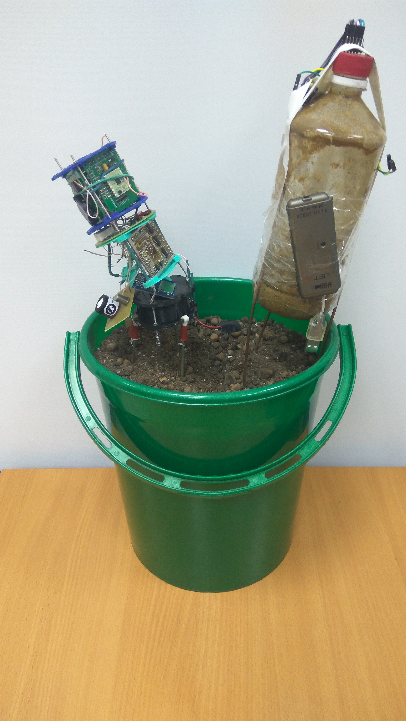
documents/IMG_20170128_160929.jpg
