granum-space/cansat-2016/structure/seeds_cover.stl

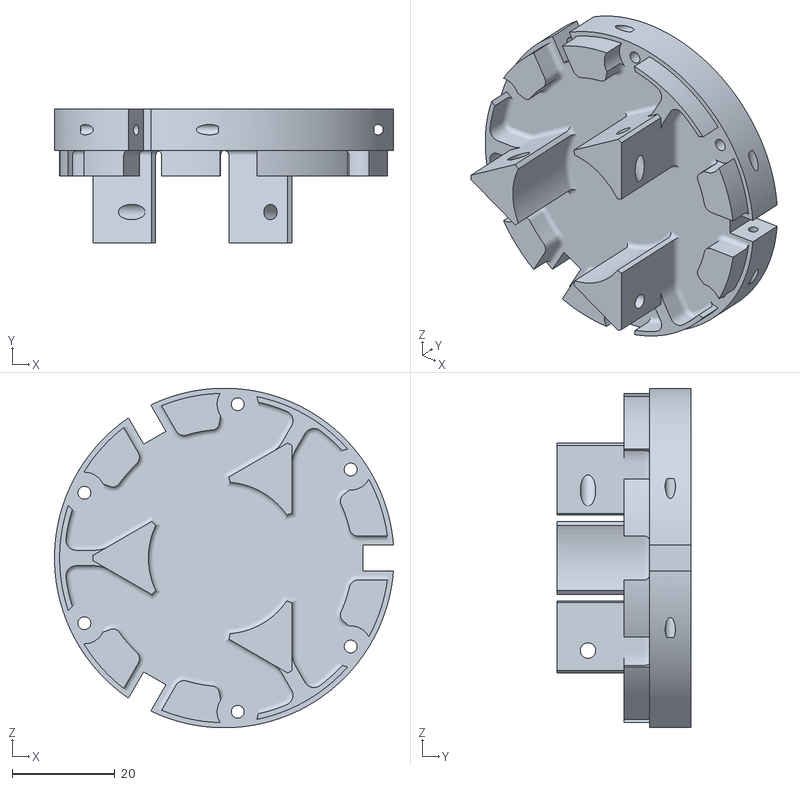
[picture p63: CAD file, 2017-04-14]
structure/seeds_cover.stl
65.9 x 26.0 x 66.0
