granum-space/cansat-2016/(list of files, cad)

Other CAD files:
structure/akkum_18650.prt
structure/akkum_18650_fake_base.prt
structure/akkum_18650_fake_top.prt
structure/bat-lead-out.prt
structure/bat_cork.prt
structure/bat_cork_cap.prt
structure/bat_cork_extender.prt
structure/case_1.prt
structure/case_2.prt
structure/case_3.prt
structure/case_all.prt
structure/dlastergney-print-surface.prt
structure/dlastergney.prt
structure/dlastergney1111.prt
structure/dlyaparachuta.prt
structure/externalcase.prt
structure/gps_antenn.prt
structure/key_nut.prt
structure/klutch.prt
structure/microkontroller.prt
structure/prismocha-print-support.prt
structure/prismochka.prt
structure/prismochka1.prt
structure/prizma.prt
structure/prizmochka_holder.prt
structure/radio.prt
structure/seeds_base.prt
structure/seeds_base_var2.prt
structure/seeds_blade.prt
structure/seeds_cover.prt
structure/seeds_servo.prt
structure/sensors.prt
structure/servo_attach.prt
structure/stage_parachute.prt
structure/stage_parachute_alt.prt
structure/stm32board.prt
structure/stm32boardhold_bottom.prt
structure/stm32boardhold_top.prt
structure/top.prt
structure/zajim.prt
structure/zond.prt
