granum-space/cansat-2016/(threads)

Thread 2 (2016-10-22):

Оформить электрические схемы аппарата

Snork2, 2016-10-22:
В первую очередь принципиальные.
Ну и возможно монтажные

Snork2, 2016-12-03:
По коммиту 259f9bb4078273acbf91862e3b251bc51d9bfd53

Аdafruit [пишет](https://www.adafruit.com/product/439) про свои модули с фотодатчиками:

> As of June 3, 2014 we are shipping a version with a 3.3V regulator and level shifting circuitry so it can be used with any 3-5V power/logic microcontroller.

Поэтому нет необходимости в обеспечении модулей TSL2561 питанием в 3.3 вольта и преобразовывать для них уровни I2C: на модуле уже есть преобразовали и для питанию и для I2C.

Внешний АЦП - ads1115: так же способен работать на 5ти вольтах и по питанию и по логике

Closed 2017-01-13.

Thread 8 (2017-02-23):

Разработать драйвер для dht22

Snork2, 2017-02-23:
Драйвер для датчика влажности и температуры

Он уже был у нас в прошлом году

https://github.com/granum-space/cansat-2015/blob/master/granum-space/src/dht022.c
https://github.com/granum-space/cansat-2015/blob/master/granum-space/src/dht022.h

Нужно просто перенести в новый репозиторий

Даташит: https://cdn-shop.adafruit.com/datasheets/DHT22.pdf

Snork2, 2017-03-13:
Его нужно просто взять из прошлогоднего репозитория

Closed 2017-05-04.

Thread 9 (2017-02-23):

Разработать драйвер для акселерометра ADXL375

Snork2, 2017-02-23:
В общей библиотеке уже есть (ну, всмысле скоро будет) драйвер для ADXL345
Хорошо бы взять его за основу и переписать на stm32

Даташит: http://www.analog.com/media/en/technical-documentation/data-sheets/ADXL375.PDF

Closed 2017-04-18.

Thread 14 (2017-03-13):

Разработать программный модуль измерения сопротивления

Snork2, 2017-03-13:
Должен опираться на АЦП, драйвер дигипота и мультиплексоры. (для мультиплексоров не стоит делать отдельных драйверов)

Общая идея - покрутили дигипот, смотрим что там на ацп, крутим снова в сторону уменьшения разности потенциалов на ацп и идем по кругу

Closed 2017-05-27.

Thread 16 (2017-06-03):

Предупреждения компилятора в soil_res.c

Snork2, 2017-06-03:
Мелочи но не приятно:

```
Building file: ../src/soil_res.c
Invoking: AVR Compiler
avr-gcc -I"/home/snork/cansat/git/granum/cansat-2016/src-board/ATmega/librscs" -I"/home/snork/cansat/git/granum/cansat-2016/src-board/ATmega/FatFS" -I"/home/snork/cansat/git/granum/cansat-2016/src-board/ATmega/src" -I"/home/snork/cansat/git/granum/cansat-2016/src-board/common" -Wall -Os -fpack-struct -fshort-enums -ffunction-sections -fdata-sections -std=gnu99 -funsigned-char -funsigned-bitfields -mmcu=atmega128 -DF_CPU=8000000UL -MMD -MP -MF"src/soil_res.d" -MT"src/soil_res.d" -c -o "src/soil_res.o" "../src/soil_res.c"
../src/soil_res.c: In function 'rscs_get_soil_res':
../src/soil_res.c:158:10: warning: variable 'error' set but not used [-Wunused-but-set-variable]
   rscs_e error;
          ^~~~~
../src/soil_res.c:122:10: warning: unused variable 'value' [-Wunused-variable]
  int16_t value;
          ^~~~~
../src/soil_res.c:193:4: warning: 'resX' may be used uninitialized in this function [-Wmaybe-uninitialized]
    printf("in volts at %d: %lu\n", j, resX);
    ^~~~~~~~~~~~~~~~~~~~~~~~~~~~~~~~~~~~~~~~
Finished building: ../src/soil_res.c
```

Snork2, 2017-06-16:
Исправили, sort of

Closed 2017-06-16.

Thread 17 (2017-06-03):

Предупреждения компилятора в ringbuf_varsize.c

Snork2, 2017-06-03:
А вот это уже не мелочи и серьезно, нужно исправить

```
Building file: ../src/ringbuf_varsize.c
Invoking: AVR Compiler
avr-gcc -I"/home/snork/cansat/git/granum/cansat-2016/src-board/ATmega/librscs" -I"/home/snork/cansat/git/granum/cansat-2016/src-board/ATmega/FatFS" -I"/home/snork/cansat/git/granum/cansat-2016/src-board/ATmega/src" -I"/home/snork/cansat/git/granum/cansat-2016/src-board/common" -Wall -Os -fpack-struct -fshort-enums -ffunction-sections -fdata-sections -std=gnu99 -funsigned-char -funsigned-bitfields -mmcu=atmega128 -DF_CPU=8000000UL -MMD -MP -MF"src/ringbuf_varsize.d" -MT"src/ringbuf_varsize.d" -c -o "src/ringbuf_varsize.o" "../src/ringbuf_varsize.c"
../src/ringbuf_varsize.c: In function 'rscs_ringbuf_varsize_push':
../src/ringbuf_varsize.c:43:3: warning: implicit declaration of function 'memcpy' [-Wimplicit-function-declaration]
   memcpy(buf->buffer + buf->head, data, buf->element_size);
   ^~~~~~
../src/ringbuf_varsize.c:43:3: warning: incompatible implicit declaration of built-in function 'memcpy'
../src/ringbuf_varsize.c:43:3: note: include '<string.h>' or provide a declaration of 'memcpy'
../src/ringbuf_varsize.c: In function 'rscs_ringbuf_varsize_push_many':
../src/ringbuf_varsize.c:55:3: warning: implicit declaration of function 'rscs_ringbuf_push'; did you mean 'rscs_ringbuf_varsize_push'? [-Wimplicit-function-declaration]
   rscs_ringbuf_push(buf, data8 + ( i * buf->element_size ));
   ^~~~~~~~~~~~~~~~~
   rscs_ringbuf_varsize_push
Finished building: ../src/ringbuf_varsize.c
```

Snork2, 2017-06-03:
А еще там одинаовый `include guard` с ringbuf из rscs. Но это я правлю rscs

Snork2, 2017-06-03:
И еще там ошибка с аргументами `memcpy`

Snork2, 2017-06-16:
Вроде исправили, но это не точно

Closed 2017-06-16.

Thread 19 (2017-06-15):

Формат пакетов крайне неудобен для обработки на Земле

Snork2, 2017-06-15:
1. Тяжело ловить пакеты нескольких типов, различающихся лишь заголовком
2. Ошибки TSL вынесены отдельно из массива, имхо было бы круче, чтобы они были вместе

Пока только это, но будет еще

Snork2, 2017-06-16:
Переоформлено в #20

Closed 2017-06-16.

Thread 20 (2017-06-16):

Замечания к структурам пакетов

Snork2, 2017-06-16:
1. Почему-то нет контрольной суммы у пакета с накопленными ускорениями
2. Ошибка TSL зачем-то вынесена из структуры

Дальше будет больше

Snork2, 2017-07-13:
Ну, оно отлетало, значит сойдет

Closed 2017-07-13.
