granum-space/cansat-2016/schematics/soil_res_scheme.brd

## EAGLE design schematics/soil_res_scheme.brd (2017-05-31)

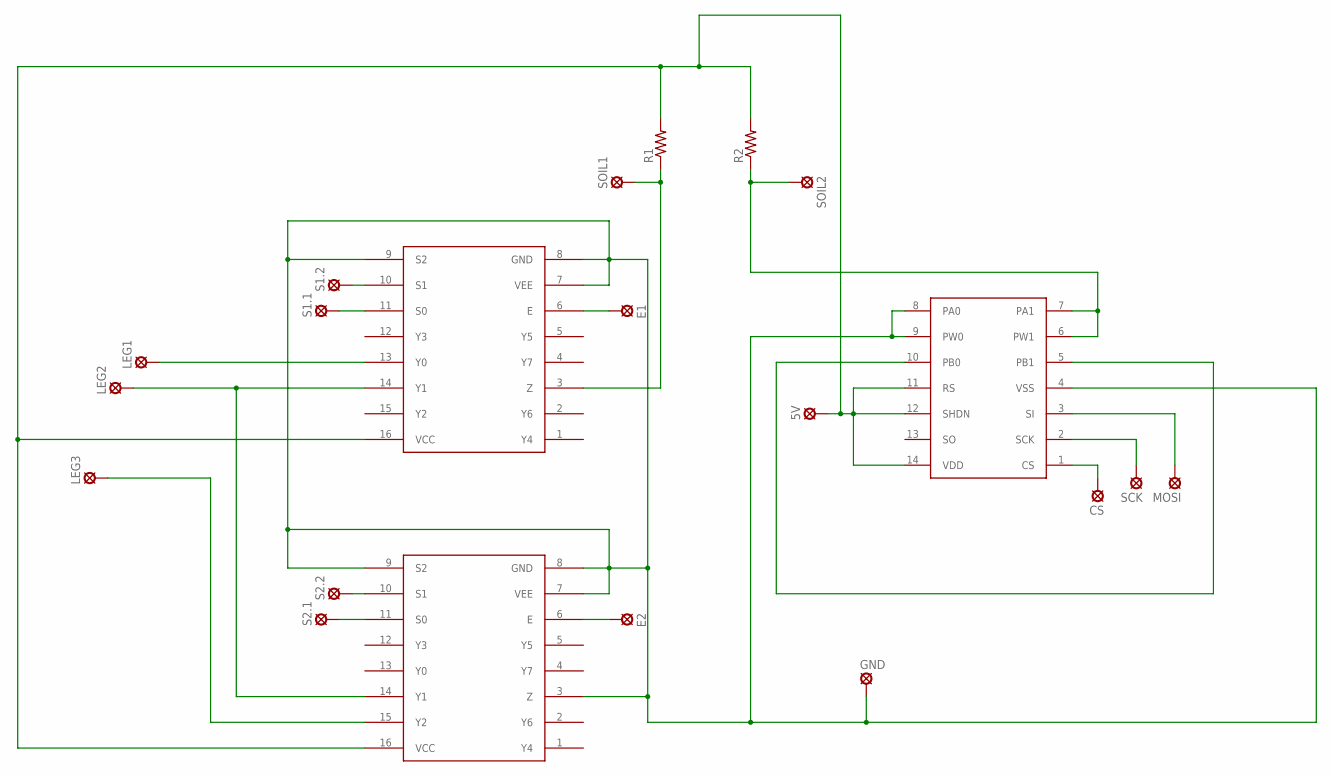
[picture p64: schematic soil_res_scheme.sch]

Parts:
5V: LSP10
CS: LSP10
E1, E2: LSP10
GND: LSP10
LEG1, LEG2, LEG3: LSP10
MOSI: LSP10
R1, R2: R-US_0207/10; 0207/10
S1.1, S1.2, S2.1, S2.2: LSP10
SCK: LSP10
SOIL1, SOIL2: LSP10
U$1: MCP42100!; DIL14
U$2, U$3: 74HC4051!; DIL16

Connections:
5V: 5V.MP, R1.2, R2.2, U$1.11 (RS), U$1.12 (SHDN), U$1.14 (VDD), U$2.16 (VCC), U$3.16 (VCC)
CS: CS.MP, U$1.1 (CS)
E1: E1.MP, U$2.6 (E)
E2: E2.MP, U$3.6 (E)
GND: GND.MP, U$1.4 (VSS), U$1.8 (PA0), U$1.9 (PW0), U$2.7 (VEE), U$2.8 (GND), U$2.9 (S2), U$3.3 (Z), U$3.7 (VEE), U$3.8 (GND), U$3.9 (S2)
MOSI: MOSI.MP, U$1.3 (SI)
unnamed: S2.2.MP, U$3.10 (S1)
unnamed: S2.1.MP, U$3.11 (S0)
unnamed: S1.1.MP, U$2.11 (S0)
unnamed: S1.2.MP, U$2.10 (S1)
unnamed: LEG1.MP, U$2.13 (Y0)
unnamed: LEG2.MP, U$2.14 (Y1), U$3.14 (Y1)
unnamed: LEG3.MP, U$3.15 (Y2)
unnamed: U$1.5 (PB1), U$1.10 (PB0)
SCK: SCK.MP, U$1.2 (SCK)
SOIL-1: R1.1, SOIL1.MP, U$2.3 (Z)
SOIL-2: R2.1, SOIL2.MP, U$1.6 (PW1), U$1.7 (PA1)

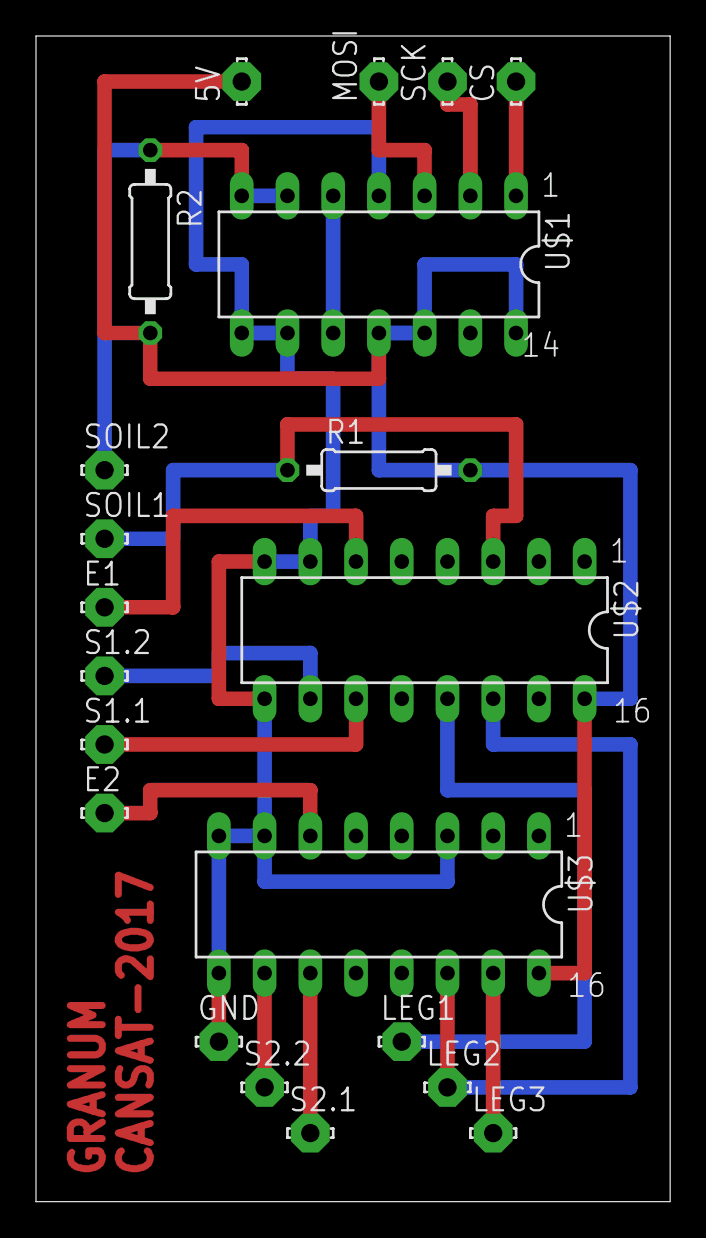
[picture p65: board soil_res_scheme.brd from above]

Board: 2 copper layers, 35.2 x 64.8 mm, 21 parts (0 on the bottom side), 17 nets.
