granum-space/cansat-2016/schematics/logic_analyser.brd

## EAGLE design schematics/logic_analyser.brd (2017-04-01)

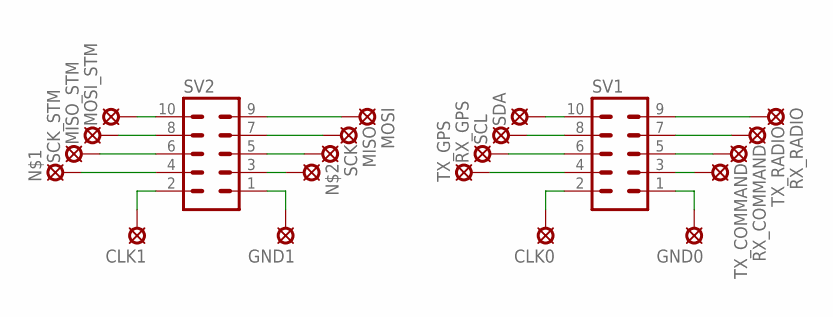
[picture p66: schematic logic_analyser.sch]

Parts:
CLK0, CLK1: LSP10
GND0, GND1: LSP10
MISO: LSP10
MISO_STM: LSP10
MOSI: LSP10
MOSI_STM: LSP10
N$1, N$2: LSP10
RX_COMMAND: LSP10
RX_GPS: LSP10
RX_RADIO: LSP10
SCK: LSP10
SCK_STM: LSP10
SCL: LSP10
SDA: LSP10
SV1, SV2: MA05-2
TX_COMMAND: LSP10
TX_GPS: LSP10
TX_RADIO: LSP10

Connections:
GND0: GND0.MP, SV1.1
GND1: GND1.MP, SV2.1
MISO: MISO.MP, SV2.7
MISO_STM: MISO_STM.MP, SV2.8
MOSI: MOSI.MP, SV2.9
MOSI_STM: MOSI_STM.MP, SV2.10
unnamed: N$1.MP, SV2.4
unnamed: N$2.MP, SV2.3
RX_COMMAND: RX_COMMAND.MP, SV1.5
RX_GPS: RX_GPS.MP, SV1.6
RX_RADIO: RX_RADIO.MP, SV1.9
SCK: SCK.MP, SV2.5
SCK0: CLK0.MP, SV1.2
SCK1: CLK1.MP, SV2.2
SCK_STM: SCK_STM.MP, SV2.6
SCL: SCL.MP, SV1.8
SDA: SDA.MP, SV1.10
TX_COMMAND: SV1.3, TX_COMMAND.MP
TX_GPS: SV1.4, TX_GPS.MP
TX_RADIO: SV1.7, TX_RADIO.MP

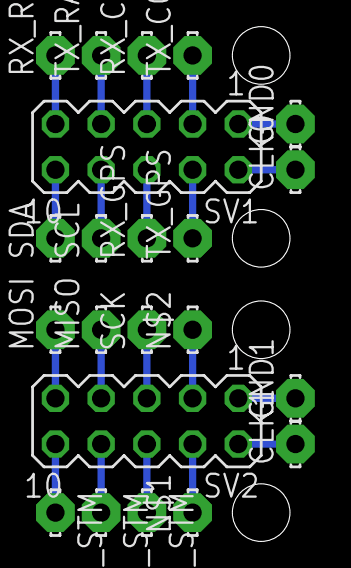
[picture p67: board logic_analyser.brd from above]

Board: 2 copper layers, 22 parts (0 on the bottom side), 20 nets.
