granum-space/cansat-2016/src-board/ATmega/src/gr_servo.h

/*
 * gr_servo.h
 *
 *  Created on: 17 июня 2017 г.
 *      Author: developer
 */

#ifndef GR_SERVO_H_
#define GR_SERVO_H_

void gr_servo_init();

void gr_servo_set(uint8_t angle);

#endif /* GR_SERVO_H_ */
