granum-space/cansat-2016/src-board/ATmega/src/stm32.h

/*
 * stm32.h
 *
 *  Created on: 07 июня 2017 г.
 *      Author: developer
 */

#ifndef STM32_H_
#define STM32_H_

void stm32_initExchange();
void stm32_updateSTMStatus();
void stm32_transmitSystemStatus();
void stm32_getAccelerations();



#endif /* STM32_H_ */
