granum-space/cansat-2016/(commit log)

2016-10-06 Структура каталогов
2016-10-22 Принес модели корпуса
    [prismochka.prt, seeds_base.prt, seeds_blade.prt, seeds_cover.prt, seeds_servo.prt]
2016-11-26 Добавлена структурная схема аппарата.
2016-11-26 Поработали над документацией
    Добавили набросок для плана-графика, пояснительную записку (неполную)
    и архитектурную схему аппарата.
    Ну и обновили чертежи (на всякий случай)
    [prismochka.prt, seeds_base.prt, seeds_blade.prt, seeds_cover.prt, seeds_servo.prt, план-график.xls]
2016-12-01 В пояснительную записку добавлены пункты
    5. Обоснование необходимости второго МК
    6. Эксперимент с МГМ
2016-12-03 В электрическую схему апппарата добавлены нарисованные элементы, прикреплена библиотека с ними (elements_cs2016) и еще очень много библиотек
    [scheme_granum2016.sch]
2016-12-03 Add files via upload
    Презентация прошлого года (pdf и pptx)
2016-12-03 Заполнили план-график, добавили в ПЗ работу над ошибками, в архитектуру добавили сервомашинку
    [план-график.xls]
2016-12-12 Отформотированна ПЗ и обновлена прошлогодняя презентация (изменения за прошлые выходые)
2016-12-24 Подготовил описание передачи пакетов
    Осталось добавить сами пакеты, вскоре доделаю
2016-12-24 Поправил форматирование за предыдущим коммитом
2016-12-24 Добавила в презентацию таблицы с массово-габаритными параметрами и бюджетом спутника + меняю формат презентации
2016-12-24 Изменено описание протокола, обновлена архитектура.
2016-12-30 Немного подправила схему и добавила пьезо-пищалку с сервоприводом
    [scheme_granum2016.sch]
2016-12-30 Обновляю презентацию
2016-12-30 добавляем в пояснительную записку описание измерительного моста + в схеме подключен мост, термисторы и немного по мелочам Гранум, с наступающим!
    [scheme_granum2016.sch]
2017-01-02 Новогодний коммит! Добавила анимацию в презентацию
2017-01-03 Добвалено описание данных между STM и ATMega, добавлена схема измерительного моста.
2017-01-04 в ПЗ добавлено описание измерения твердости, в презентации изменено расширение видео, в схемах теперь подключены STM32, microSD & GPS, в библиотеке есть ATmega128
    [scheme_granum2016.sch]
2017-01-05 Исправлена опечатка в описании способа измерения сопротивления
2017-01-05 подправила мостовую схему
    [scheme_granum2016.sch]
2017-01-05 финальные этапы в разработке принципиальной ЭС. изменен измерительный мост, добавлены выводы для контрольно-испытательной аппаратуры, а вся аппаратура подключена к МК
    Удалены лишние файлы
    [scheme_granum2016.sch]
2017-01-05 Подправлена архитектура (заменены дачтики)
2017-01-12 Работа над ПЗ
2017-01-14 Работа над презентацией, структурой пз, моделями
2017-01-18 Подвел ТЗ
2017-01-18 Убрал старые файлы. подработал презентацию
    [план-график.xls]
2017-01-19 Плоды работы за 19.01
2017-01-21 Плоды работы за 21.01
2017-01-22 заменила картинки с конструкцией в презентации и подредактировала ПЗ
2017-01-22 Финальные правки ПЗ
2017-01-22 Еще более финальные правки
2017-01-22 Исправил опечатки
2017-01-22 Еще еще более фильные правки
2017-01-22 Ну вот теперь совсем финальные правки
2017-01-22 Ну просто наифинальнейшие изменения
2017-01-22 Релиз!
2017-01-23 Доработаны модели, в презентацию добавлен слайд с рассчётом сопротивления
2017-01-26 Доработана презентация, добавлены документы с распределением ролей и текстом выступления
2017-01-27 Доработана презентация (почти окончательно), энергопотребление GPS добавлено в ПЗ, актуализарованы номера страниц в ролях и сценарии
2017-01-27 Перенес картинки в отдельную папку
2017-01-29 добавила анимацию в расширении .gif и .mp4
2017-01-30 Изменения от 29.01.17
2017-02-14 Анин корпус(немного доработан), переименовал главную сборку в all.asm
2017-03-11 готова плата с блоком переключения стержней
    [bridgeScheme.brd, bridgeScheme.sch]
2017-03-14 Дал имена всем сигналам, исправил две ошибки на плате, утолщил и переразвел некоторые сигналы без переходных отверстий. (Строго говоря всеравно с ними, но они теперь в ножках микросхем)
    [bridgeScheme.brd, bridgeScheme.sch]
2017-04-01 добавлена плата логического анализатора
    [bridgeScheme.brd, logic_analyser.brd, logic_analyser.sch]
2017-04-04 Последние версии моделек
2017-04-05 Последние версии моделей (после Вячеслава)
2017-04-07 Начат проект под стм
2017-04-07 Начато написание adxl375
2017-04-07 Работы над ADXL
2017-04-08 Изменения за 8.4.17
2017-04-11 Доработана пробка батарейного отсека
    [akkum_18650.prt, bat_cork.prt, case_3.prt, case_all.prt, dlastergney.prt, dlastergney1111.prt, dlyaparachuta.prt, externalcase.prt]
2017-04-11 потерялись
    [case_1.prt, case_2.prt]
2017-04-14 Последние изменения
    [bat_cork.prt, case_1.prt, dlastergney.prt, key_nut.prt, klutch.prt, prismochka.prt, prismochka1.prt, seeds_base.prt]
2017-04-15 Начат проект под STM, почти вся стандартная программа (бмп диковат) побеждена
2017-04-18 Крышка батарейного отсека с учетом крепления ключа гайков
    [bat_cork.prt, bat_cork_cap.prt]
2017-04-29 Написаны все функции, необходимые для работы с дигипотом
2017-05-02 Доведены до работы многие датчики
2017-05-02 Дигипот работает!!!
2017-05-02 Наземка доведена до очень даже рабочего состояния! (и, да, впервые закоммичена)
2017-05-03 Сделано так, чтобы работало
2017-05-03 Обновление наземки
2017-05-03 Новый rscs мастер, правильная связка с common и обновление gitignore под все конфигурации
2017-05-04 Исправил настойки проекта - пересвязал с новым мастером
2017-05-06 Дописан код для дигипота для получения сопротивления с двух встроенных реостатов; Полностью дописана функция измерения (требуется тест)
2017-05-13 Повесила схему на внешний ацп, внесла изменения в функцию записи сопротивления и изменила логику измерения
2017-05-17 Самую малость поправил настройки проекта для гарантированно-корректного распознования librscs как каталога с исходными кодами
2017-05-17 it works!!1 теперь схема достаточно точно мерит сопротивление!
2017-05-19 Как давно мы не коммитили!
    [план-график.xlsx]
2017-05-19 Работа над STM частью
2017-05-20 тест схемы на предмет работы мультиплексоров
2017-05-20 в функции get_res_test() представлен иной способ нахождения минимальной разницы потенциалов
2017-05-20 На STM приём - передача SPI работает
2017-05-20 Начата интеграция GPS
2017-05-24 осуществлен более быстрый способ получения сопротивления
2017-05-24 Попытки завести GPS
2017-05-24 Накопленные изменения
    [akkum_18650_fake_base.prt, akkum_18650_fake_top.prt, bat_cork.prt, bat_cork_cap.prt, dlastergney-print-surface.prt, dlastergney.prt, prizmochka_holder.prt, seeds_base.prt]
2017-05-25 Распоры для резинок
    [dlastergney.prt, seeds_base.prt, seeds_cover.prt]
2017-05-25 Передача питания через переключатель без противного кабеля
    [bat-lead-out.prt, bat_cork.prt, bat_cork_cap.prt, prismochka1.prt, seeds_base.prt, seeds_cover.prt]
2017-05-25 Мелкие доделки, подготовка на печать
    [dlastergney.prt, seeds_cover.prt]
2017-05-27 Для STM32 портирован GPS-nmea модуль, настроен printf в 3 uart
2017-05-27 Обновлены структуры пакетов, добавлен кольцевой буфер для работы со значениями произвольной длины
2017-05-28 Фланец для резинок
    [seeds_base.prt]
2017-05-29 Правки фланцев под резинки и держатели для стежней на призме
    [prismochka1.prt, seeds_base.prt, seeds_cover.prt]
2017-05-30 Призма на перепечать
    [prismochka1-print.prt, prismochka1-print.stl, prismochka1.prt]
2017-05-31 а вот и схемы
    [soil_res_scheme.brd, soil_res_scheme.sch]
2017-05-31 FreeRTOS, ringbuf_varsize, исправления, причёсывание кода
    [adxl375.c, globalwars.h, gps_nmea.c, granum_globals.c, granum_globals.h, main.c]
2017-05-31 Комментарии к доделкам
2017-05-31 Настроил freertos, навел порядок в проекте
2017-06-01 увеличенная полость для контактного кольца
    [prismocha-print-support.prt, prismochka1-print.prt, prismochka1-print.stl, prismochka1.prt]
2017-06-02 Добавлена FatFS, прикручен dump
2017-06-03 Добавлены файлы модуля анализа ускорений
2017-06-03 Исправил варнинги в fatfs, пересвязался с новым мастером и подправил инклюды и конфигурации проекта
2017-06-05 Много всего для атмеги
2017-06-05 Крышка батарейного отсека переделана в надежде её таки упихать
    [bat-lead-out.prt, bat_cork.prt, bat_cork_cap.prt, prismochka1.prt]
2017-06-05 Предложения и замечания
2017-06-06 Комментарий, Правка табуляций и улучшение крышки батарейного отсека
    [bat_cork.prt]
2017-06-06 Вынес в отдельный файл опрос датчиков, добавил сохранение ошибок в пакет
2017-06-06 Держалка для стм32
    [stm32board.prt, stm32boardhold_bottom.prt, stm32boardhold_top.prt]
2017-06-07 Правки по результатам печати
    [bat_cork_cap.prt, stm32board.prt, stm32boardhold_bottom.prt, stm32boardhold_top.prt]
2017-06-09 Удлинитель пробки для батарейки
    [bat_cork_cap.prt, bat_cork_extender.prt]
2017-06-12 Давно не коммитили
2017-06-15 Начата (никак не закончена!) работа по переводу всего на RTOS
2017-06-15 Замечания предложения
2017-06-15 Я, кажется, стмку почти закончил
2017-06-15 Замечания и предложения
2017-06-16 Правки, правки, исправления!
2017-06-17 Серва и пережигатели
2017-06-17 Правочки STM
2017-06-17 Указы и директивы к STM32 и несколько исправлений по ходу.
    Скорее всего это нужно вмержить в мастер, тут много чего настроено в плане конфигураций.
    [gps_nmea.c, spiwork.c]
2017-06-17 ВОЙНА ВАРНИНГАМ
    И теперь проект хотябы компилится моим компилятором. По остальным старым замечаниям по прежнему нет реакции
2017-06-22 Стоит коммитить чаще.
2017-06-24 Почти доделана атмега, исправлено много ошибок и замечаний на стм
    [adxl375.c, gps_nmea.c, granum_config.h, librscs_config.h, main.c, ringbuf.c, spiwork.c]
2017-06-27 Пляски над стмкой
2017-06-28 5 дней до краха
2017-06-29 Колдунства Василия над СТМ
2017-06-29 Исправлены частоты SPI и откалибрована серва 4 дня до краха
    [gr_servo.c, granum_config.h, librscs_config.h, main.c, soil_res.c, stm32.c]
2017-06-29 Починил GPS?
2017-06-29 Чистка мусора
2017-06-29 Вроде ничего не забыл - теоретически все работает
2017-06-29 Теперь атмега компилится
2017-06-29 Забытое
2017-06-30 Исправил ошибку с кареткой DMA в gps модуле. Вынес инициализационные структуры в отдельные "scope", чтобы уменьшить требования к стеку
    [adxl375.c, gps_nmea.c, spiwork.c]
2017-06-30 Кажется теперь все работает!
2017-07-01 Что-то работает
2017-07-02 Немного приблизились к полной работоспособности
2017-07-02 Доделки наземки
2017-07-02 GPS Теперь фильтрует плохие сообщения. Вроде
2017-07-02 ПРавки для отладки блокировки по ускорениям
2017-08-08 Финальный коммит (с опозданием на месяц. И да, мы летели не спуллив последние 4 коммита из гита. Косяк! Косяк!) Всем спасибо за это "Творчество".
    [GRANUM_telemetry_acc - Copy.csv, GRANUM_telemetry_acc.csv, GRANUM_telemetry_acc_cut.csv, GRANUM_telemetry_fast.csv, GRANUM_telemetry_slow.csv, GRANUM_telemetry_soslow.csv, GRANUM_telemetry_stm.csv, seeds_cover.stl]
2017-09-26 Презентация
    Не последняя версия, но другой у меня нет
2017-11-28 Презентация с летней сессии
2018-07-21 бэкпорт фикса страшнючего бага
